scefrom/SF68/SF68.png

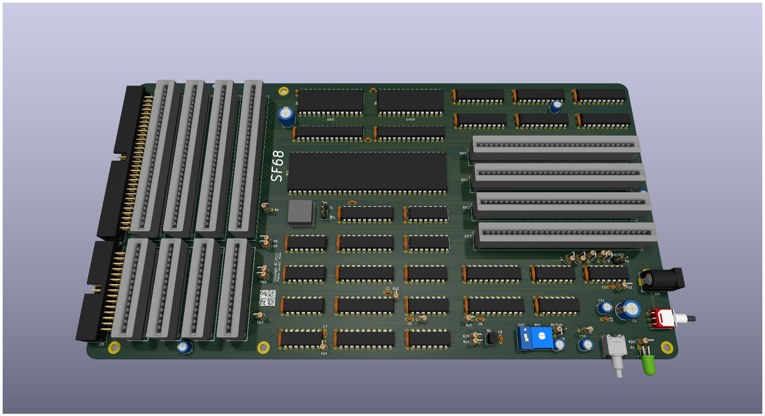
SF68.png
