scefrom/SF68/floppy/floppy_unrendered.png

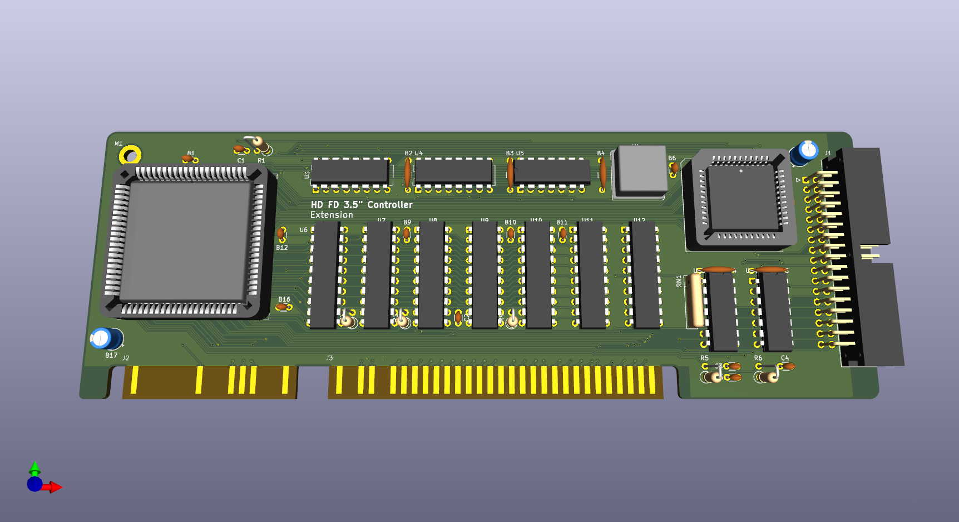
floppy/floppy_unrendered.png
