scefrom/SF68/floppy/floppy.png

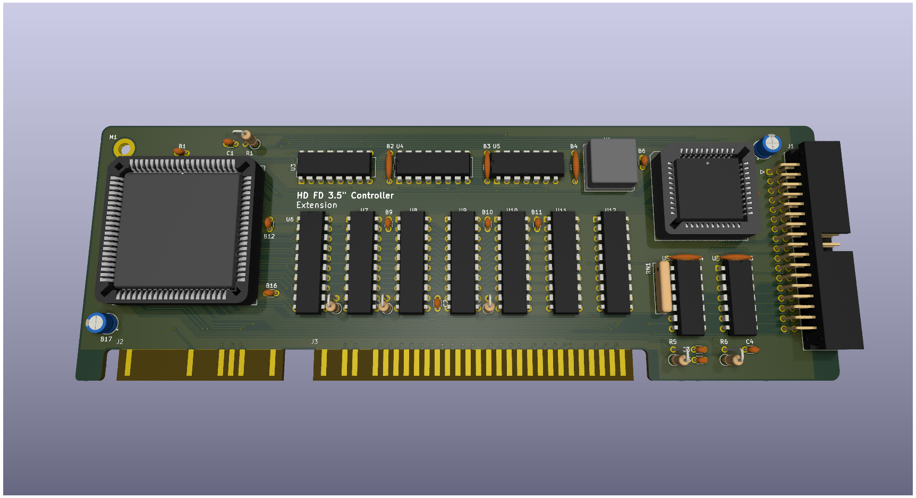
floppy/floppy.png
