scefrom/SF68/FOHWLdm.png

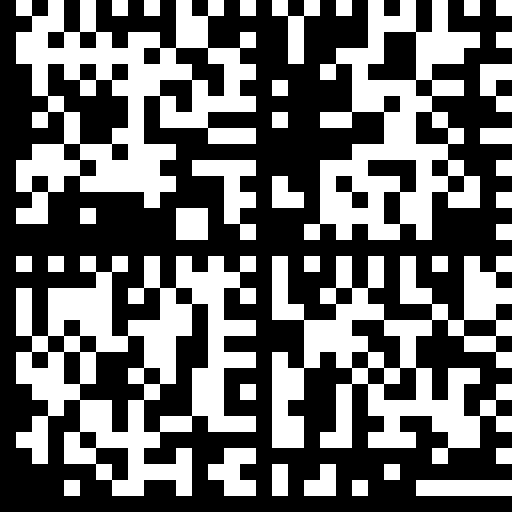
FOHWLdm.png
