scefrom/SF68/lcd2x16/lcd2x16.png

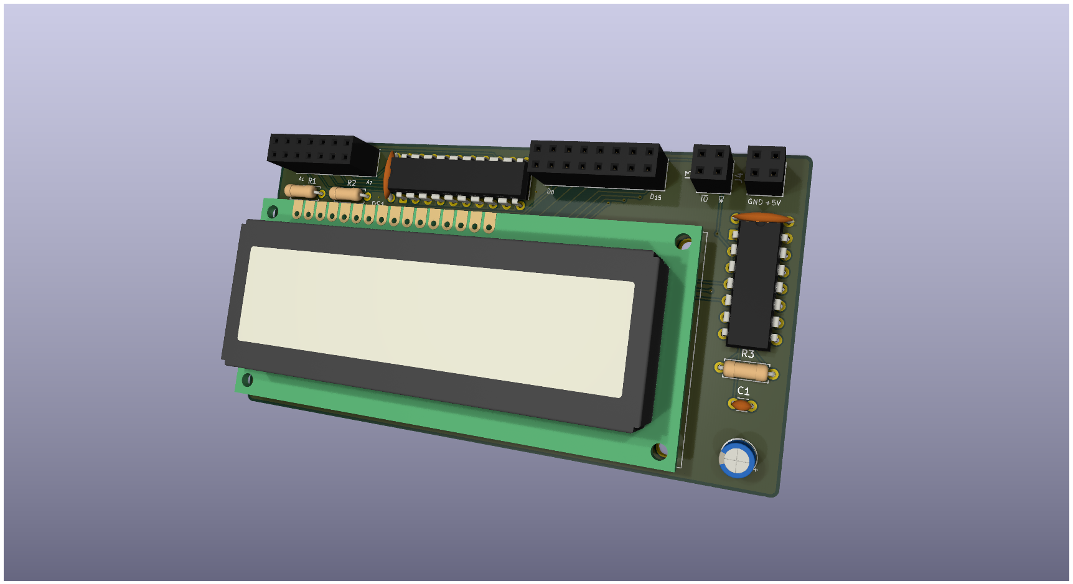
lcd2x16/lcd2x16.png
