scefrom/SF68/ps2/ps2.png

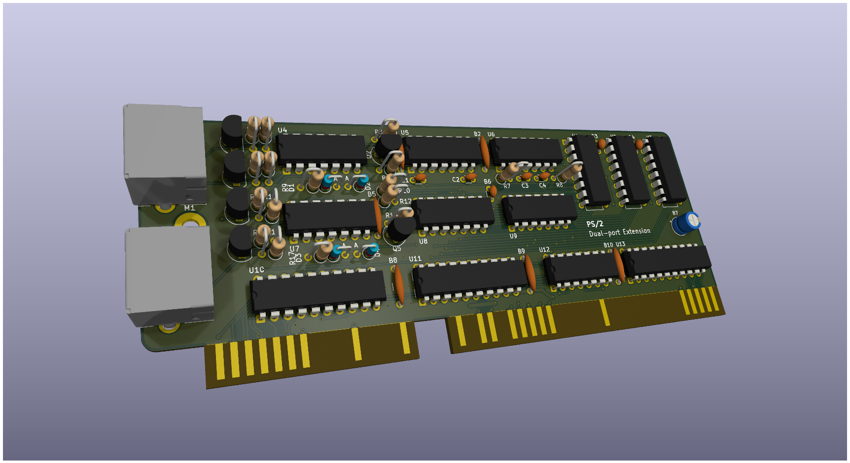
ps2/ps2.png
