scefrom/SF68/ps2/ps2_notht.png

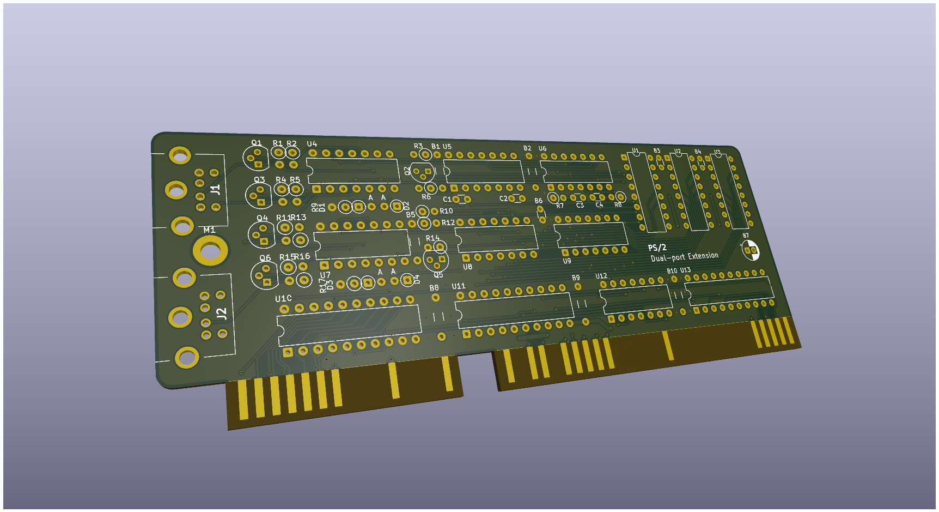
ps2/ps2_notht.png
