scefrom/SF68/ram1M/ram1M.png

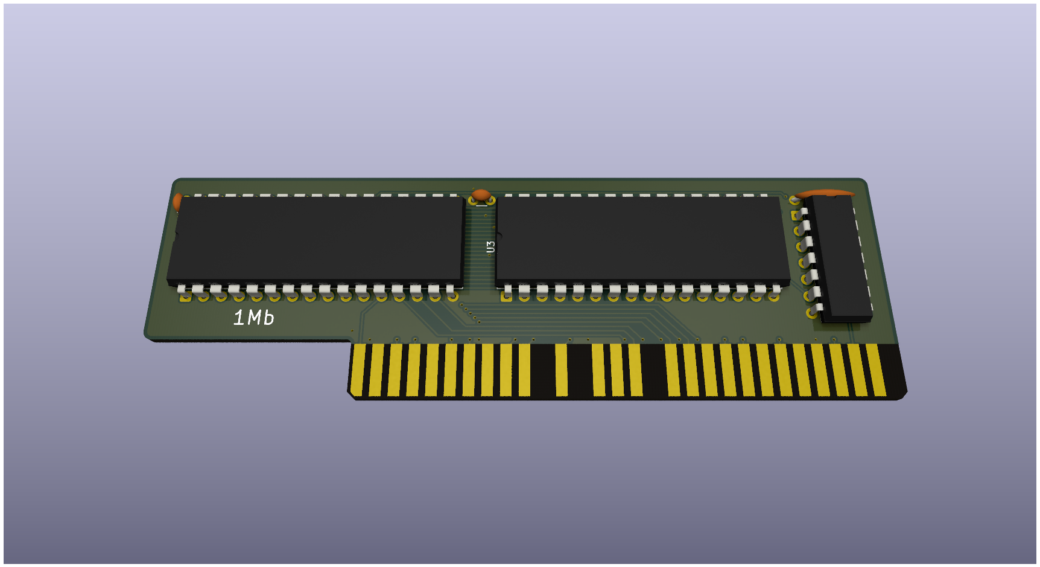
ram1M/ram1M.png
