scefrom/SF68/uart/uart/uart.png

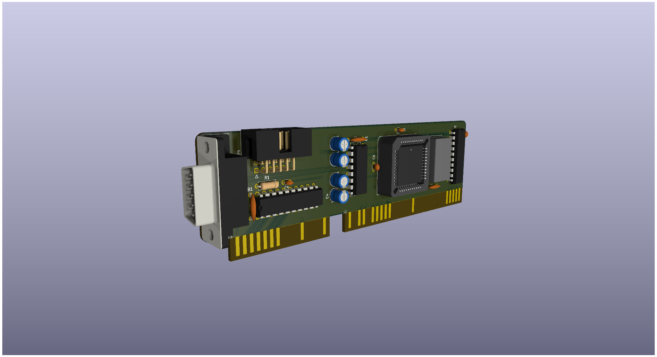
uart/uart/uart.png
