scefrom/SF68/vga/fctlines/vga_cpld_fctlines.png

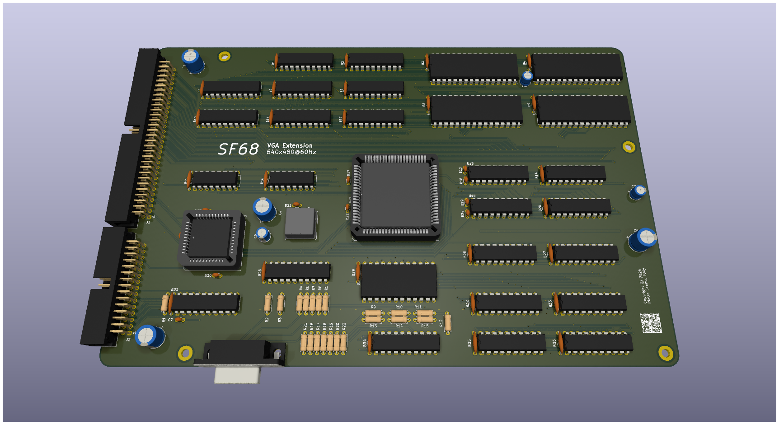
vga/fctlines/vga_cpld_fctlines.png
