scefrom/SF68/vga/jtag_fctlines/vga_cpld_jtag_fctlines.png

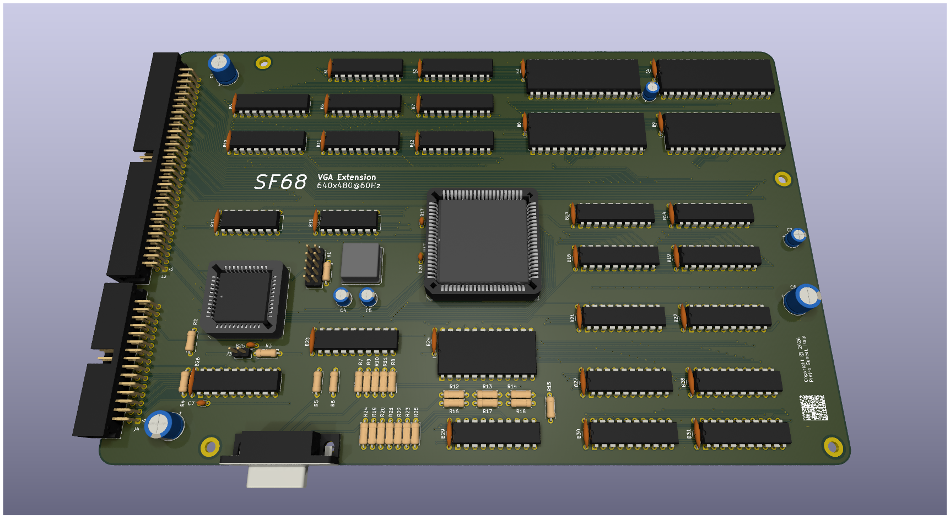
vga/jtag_fctlines/vga_cpld_jtag_fctlines.png
