scefrom/SF68/vga/vga_cpld.png

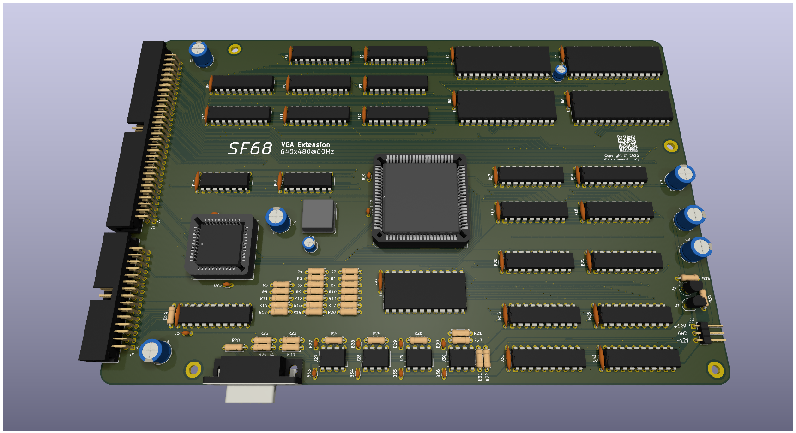
vga/vga_cpld.png
