scefrom/SF68/vga/vga_cpld_name.png

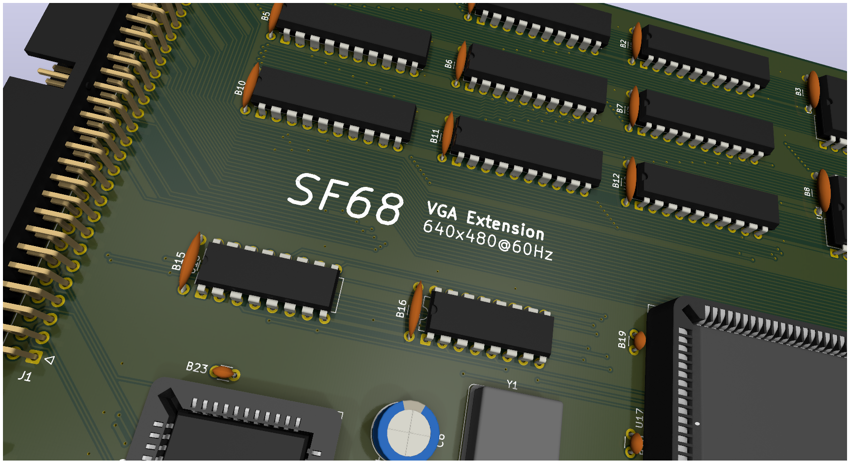
vga/vga_cpld_name.png
