scefrom/SF68/vga/vga_cpld_notht.png

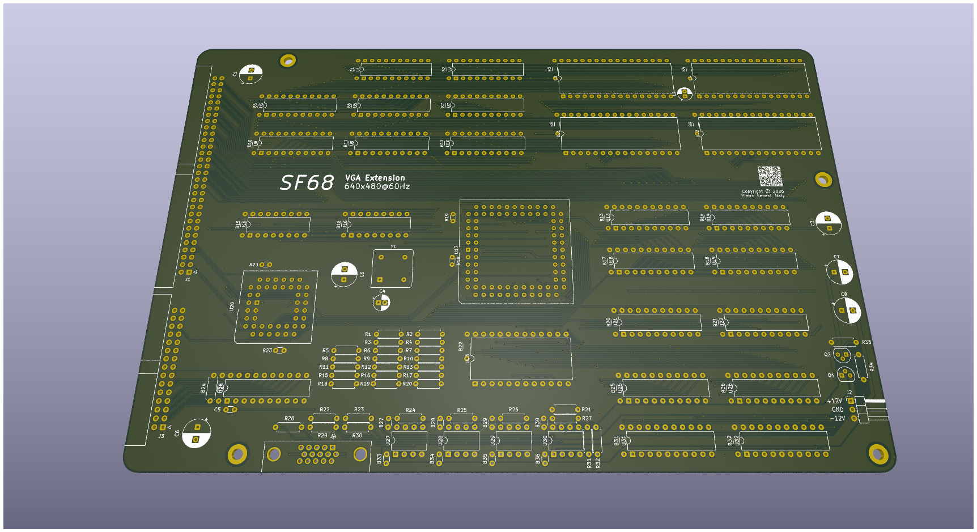
vga/vga_cpld_notht.png
