scefrom/SF68/vga/vga_palette_512x128.png

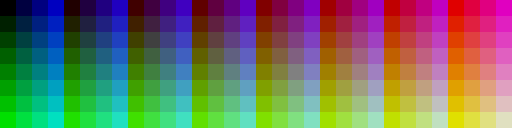
vga/vga_palette_512x128.png
