scefrom/SF68/vga/fctlines/vga_cpld_fctlines.pdf

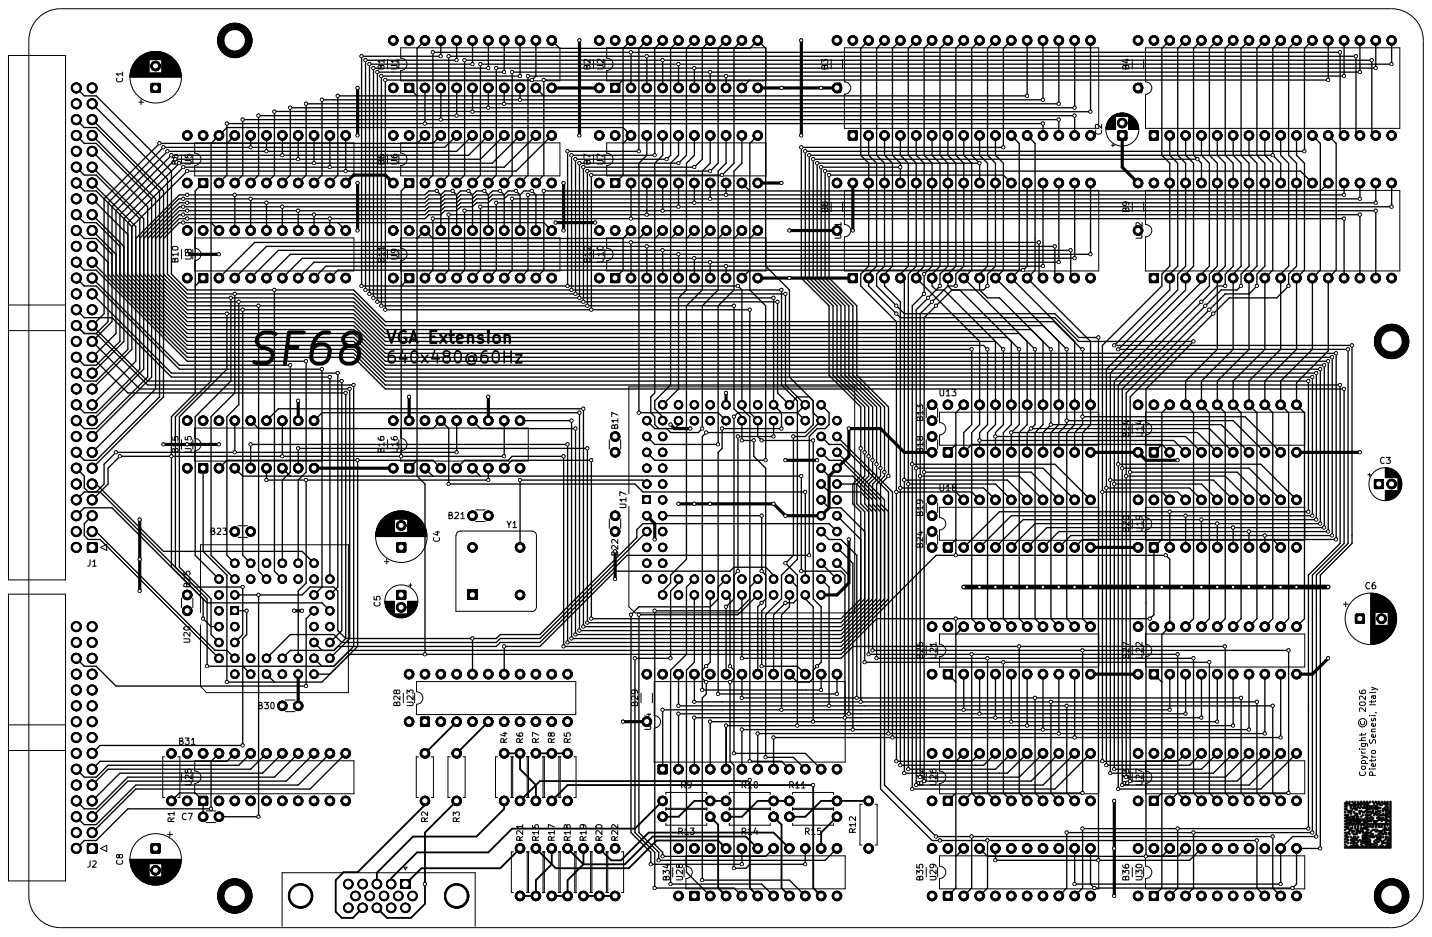
[picture p16: page 1]
