scefrom/SF68/vga/fctlines/vga_cpld_fctlines.kicad_pcb

## KiCad design vga/fctlines/vga_cpld_fctlines.kicad_pcb (2026-09-20)

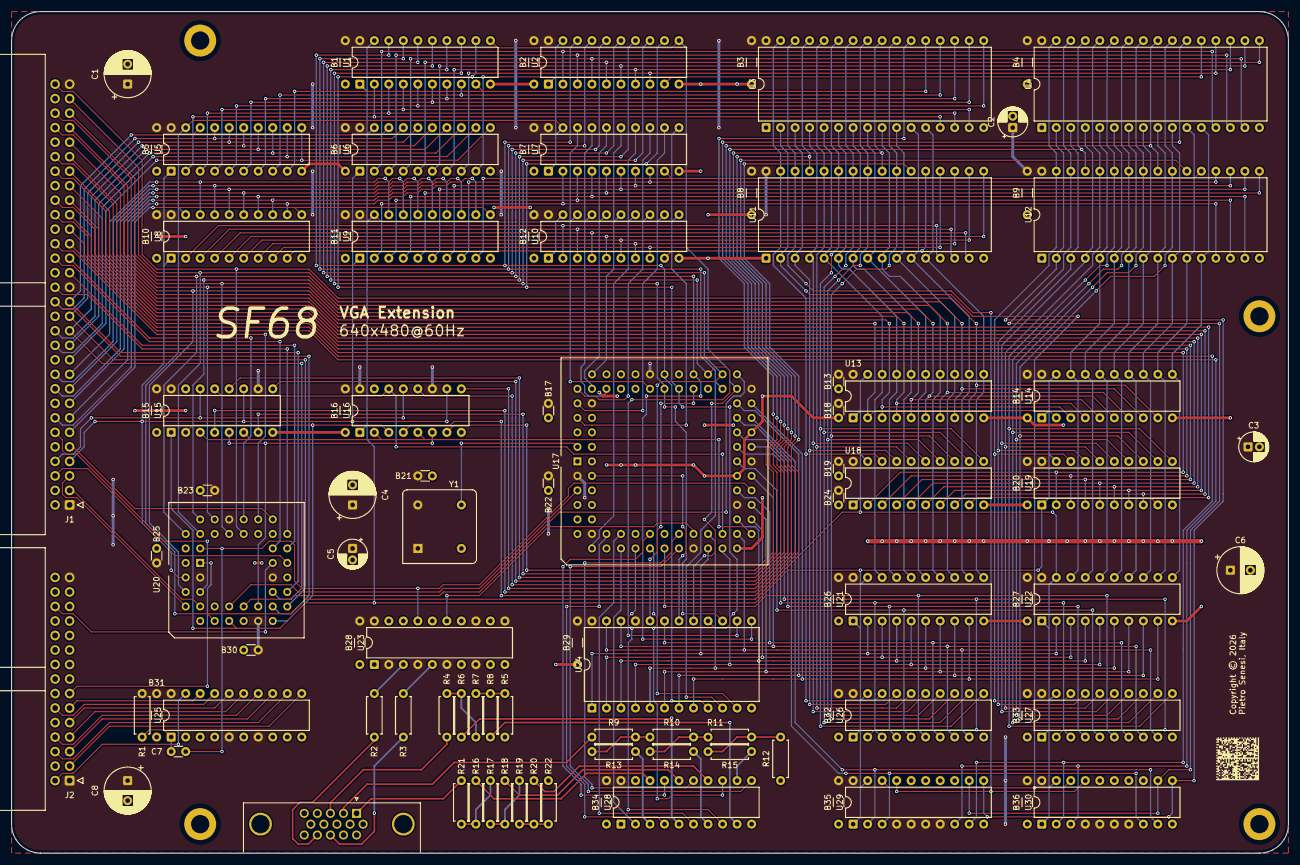
[picture p17: board vga_cpld_fctlines.kicad_pcb from above]

Board: 2 copper layers, 223.5 x 147.3 mm, 104 parts (0 on the bottom side), 214 nets.

Parts:
B1, B2, B3, B4, B5, B6, B7, B8, B9, B10, B11, B12, B14, B15, B16, B20, B26, B27, B28, B29, B31, B32, B33, B34, B35, B36: 100n; C_Disc_D3.0mm_W1.6mm_P7.62mm
B13, B17, B18, B19, B21, B22, B23, B24, B25, B30: 100n; C_Disc_D3.0mm_W1.6mm_P2.54mm
C1, C4, C6, C8: 100u; CP_Radial_D8.0mm_P3.50mm
C2, C3, C5: 10u; CP_Radial_D5.0mm_P2.00mm
C7: 22p; C_Disc_D3.0mm_W1.6mm_P2.54mm
J1: perslota; IDC-Header_2x30_P2.54mm_Horizontal
J2: perslotb; IDC-Header_2x15_P2.54mm_Horizontal
J3: vga_connector; DSUB-15-HD_Socket_Horizontal_P2.29x1.90mm_EdgePinOffset3.03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
M1, M2, M3, M4: MountingHole_3.2mm_M3_DIN965_Pad
R1: 4.7k; R_Axial_DIN0207_L6.3mm_D2.5mm_P7.62mm_Horizontal
R2, R3: 75; R_Axial_DIN0207_L6.3mm_D2.5mm_P7.62mm_Horizontal
R4: 226; R_Axial_DIN0207_L6.3mm_D2.5mm_P7.62mm_Horizontal
R5, R6, R8, R12, R13, R14, R15, R16, R18, R20, R22: 200; R_Axial_DIN0207_L6.3mm_D2.5mm_P7.62mm_Horizontal
R7, R10, R11, R17, R19: 100; R_Axial_DIN0207_L6.3mm_D2.5mm_P7.62mm_Horizontal
R9, R21: 294; R_Axial_DIN0207_L6.3mm_D2.5mm_P7.62mm_Horizontal
U1, U2, U7, U10, U13, U14, U18, U19, U21, U22, U26, U27, U29, U30: 74AHC541; DIP-20_W7.62mm
U3, U4, U11, U12: AS6C4008-55PCN; DIP-32_W15.24mm
U5, U6, U8, U9: 74HC245; DIP-20_W7.62mm
U15, U16: 74HC157; DIP-16_W7.62mm
U17: ATF1508AS-xJx84; PLCC-84_THT-Socket
U20: ATF1502AS-xJx44; PLCC-44_THT-Socket
U23, U28: CY74FCT244; DIP-20_W7.62mm
U24: AT28C16; DIP-24_W15.24mm
U25: 74HC541; DIP-20_W7.62mm
Y1: CXO_DIP8_25.175MHz; Oscillator_DIP-8

Connections:
+5V: B1.1, B2.1, B3.1, B4.1, B5.1, B6.1, B7.1, B8.1, B9.1, B10.1, B11.1, B12.1, B13.1, B14.1, B15.1, B16.1, B17.1, B18.1, B19.1, B20.1, B21.1, B22.1, B23.1, B24.1, B25.1, B26.1, B27.1, B28.1, B29.1, B30.1, B31.1, B32.1, B33.1, B34.1, B35.1, B36.1, C1.1, C2.1, C3.1, C4.1, C5.1, C6.1, C8.1, J1.1, J1.31, J1.59, J2.1, J2.29, R1.1, U1.20 (VCC), U2.20 (VCC), U3.32 (VCC), U4.32 (VCC), U5.20 (VCC), U6.20 (VCC), U7.20 (VCC), U8.20 (VCC), U9.20 (VCC), U10.20 (VCC), U11.32 (VCC), U12.32 (VCC), U13.20 (VCC), U14.20 (VCC), U15.10 (I1c), U15.16 (VCC), U16.11 (I0c), U16.16 (VCC), U17.3 (VCC_INT), U17.13 (VCC_IO), U17.26 (VCC_IO), U17.38 (VCC_IO), U17.43 (VCC_INT), U17.53 (VCC_IO), U17.66 (VCC_IO), U17.78 (VCC_IO), U18.20 (VCC), U19.20 (VCC), U20.3 (VCC), U20.15 (VCC), U20.23 (VCC), U20.35 (VCC), U21.20 (VCC), U22.20 (VCC), U23.2, U23.4, U23.6, U23.8, U23.11, U23.13, U23.20 (VCC), U24.21 (~WE), U24.24 (VCC), U25.5 (A3), U25.7 (A5), U25.20 (VCC), U26.20 (VCC), U27.20 (VCC), U28.20 (VCC), U29.4 (A2), U29.5 (A3), U29.6 (A4), U29.7 (A5), U29.20 (VCC), U30.4 (A2), U30.5 (A3), U30.6 (A4), U30.7 (A5), U30.20 (VCC), Y1.1 (EN), Y1.8 (Vcc)
/AC.~P: J2.26, U20.25 (I/O/PD2)
/ADR_{0}: U17.51 (I/O), U21.9 (A7), U22.9 (A7), U24.8 (A0)
/ADR_{1}: U17.52 (I/O), U21.8 (A6), U22.8 (A6), U24.7 (A1)
/ADR_{2}: U17.37 (I/O), U21.7 (A5), U22.7 (A5), U24.6 (A2)
/ADR_{3}: U17.29 (I/O), U21.6 (A4), U22.6 (A4), U24.5 (A3)
/ADR_{4}: U17.30 (I/O), U21.5 (A3), U22.5 (A3), U24.4 (A4)
/ADR_{5}: U17.36 (I/O), U21.4 (A2), U22.4 (A2), U24.3 (A5)
/ADR_{6}: U17.35 (I/O), U21.3 (A1), U22.3 (A1), U24.2 (A6)
/ADR_{7}: U17.28 (I/O), U21.2 (A0), U22.2 (A0), U24.1 (A7)
/ADR_{8}: U17.34 (I/O), U24.23 (A8), U26.9 (A7), U27.9 (A7)
/ADR_{9}: U17.41 (I/O), U24.22 (A9), U26.8 (A6), U27.8 (A6)
/ADR_{10}: U17.40 (I/O), U24.19 (A10), U26.7 (A5), U27.7 (A5)
/ADR_{11}: U17.22 (I/O), U26.6 (A4), U27.6 (A4)
/ADR_{12}: U17.44 (I/O), U26.5 (A3), U27.5 (A3)
/ADR_{13}: U17.48 (I/O), U26.4 (A2), U27.4 (A2)
/ADR_{14}: U17.46 (I/O), U26.3 (A1), U27.3 (A1)
/ADR_{15}: U17.45 (I/O/PD2), U26.2 (A0), U27.2 (A0)
/ADR_{16}: U17.49 (I/O), U29.2 (A0), U30.9 (A7)
/ADR_{17}: U17.50 (I/O), U29.3 (A1), U30.8 (A6)
/A_{1}: J1.60, U13.9 (A7), U14.9 (A7), U20.34 (I/O)
/A_{2}: J1.57, U13.8 (A6), U14.8 (A6), U20.41 (I/O/GCLK3)
/A_{3}: J1.55, U13.7 (A5), U14.7 (A5), U20.40 (I/O)
/A_{4}: J1.56, U13.6 (A4), U14.6 (A4), U20.39 (I/O)
/A_{5}: J1.53, U13.5 (A3), U14.5 (A3), U20.36 (I/O)
/A_{6}: J1.54, U13.4 (A2), U14.4 (A2), U20.37 (I/O)
/A_{7}: J1.51, U13.3 (A1), U14.3 (A1), U20.4 (I/O)
/A_{8}: J1.49, U13.2 (A0), U14.2 (A0)
/A_{9}: J1.50, U18.9 (A7), U19.9 (A7)
/A_{10}: J1.47, U18.8 (A6), U19.8 (A6)
/A_{11}: J1.48, U18.7 (A5), U19.7 (A5)
/A_{12}: J1.45, U18.6 (A4), U19.6 (A4)
/A_{13}: J1.43, U18.5 (A3), U19.5 (A3)
/A_{14}: J1.44, U18.4 (A2), U19.4 (A2)
/A_{15}: J1.41, U18.3 (A1), U19.3 (A1)
/A_{16}: J1.42, U18.2 (A0), U19.2 (A0)
/A_{17}: J1.39, U29.9 (A7), U30.2 (A0)
/A_{18}: J1.37, U29.8 (A6), U30.3 (A1)
/A_{19}: J1.38, U20.31 (I/O)
/A_{20}: J1.35, U20.33 (I/O)
/A_{21}: J1.36, U20.27 (I/O)
/A_{22}: J1.33, U20.26 (I/O)
/A_{23}: J1.32, U20.28 (I/O)
/BE.~IO: J1.12, U20.5 (I/O)
/BE.~M: J1.9, U20.29 (I/O)
/CLK: U17.83 (I/GCLK1), Y1.5 (OUT)
/CM: U17.5 (I/O), U20.12 (I/O)
/DAT_{0}: U1.18 (Y0), U2.18 (Y0), U17.64 (I/O), U24.9 (D0)
/DAT_{1}: U1.17 (Y1), U2.17 (Y1), U17.57 (I/O), U24.10 (D1)
/DAT_{2}: U1.16 (Y2), U2.16 (Y2), U17.56 (I/O), U24.11 (D2)
/DAT_{3}: U1.15 (Y3), U2.15 (Y3), U17.60 (I/O), U24.13 (D3)
/DAT_{4}: U1.14 (Y4), U2.14 (Y4), U17.58 (I/O), U24.14 (D4)
/DAT_{5}: U1.13 (Y5), U2.13 (Y5), U17.65 (I/O), U24.15 (D5)
/DAT_{6}: U1.12 (Y6), U2.12 (Y6), U17.63 (I/O), U24.16 (D6)
/DAT_{7}: U1.11 (Y7), U2.11 (Y7), U17.55 (I/O), U24.17 (D7)
/DAT_{8}: U7.18 (Y0), U10.18 (Y0), U17.67 (I/O)
/DAT_{9}: U7.17 (Y1), U10.17 (Y1), U17.73 (I/O)
/DAT_{10}: U7.16 (Y2), U10.16 (Y2), U17.76 (I/O)
/DAT_{11}: U7.15 (Y3), U10.15 (Y3), U17.74 (I/O)
/DAT_{12}: U7.14 (Y4), U10.14 (Y4), U17.12 (I/O/PD1)
/DAT_{13}: U7.13 (Y5), U10.13 (Y5), U17.75 (I/O)
/DAT_{14}: U7.12 (Y6), U10.12 (Y6), U17.77 (I/O)
/DAT_{15}: U7.11 (Y7), U10.11 (Y7), U17.79 (I/O)
/DIR.~R: J1.8, U15.14 (I0d), U16.13 (I1d)
/DIR.~W: J1.7, U5.1 (A->B), U6.1 (A->B), U8.1 (A->B), U9.1 (A->B), U15.11 (I0c), U16.10 (I1c), U20.2 (I/GCLK2/OE2)
/DS.~L: J1.6, U20.24 (I/O)
/DS.~U: J1.5, U20.6 (I/O)
/D_{0}: J1.29, U5.18 (B0), U6.18 (B0), U20.20 (I/O)
/D_{1}: J1.30, U5.17 (B1), U6.17 (B1), U20.19 (I/O)
/D_{2}: J1.27, U5.16 (B2), U6.16 (B2), U20.18 (I/O)
/D_{3}: J1.25, U5.15 (B3), U6.15 (B3), U20.21 (I/O)
/D_{4}: J1.26, U5.14 (B4), U6.14 (B4)
/D_{5}: J1.23, U5.13 (B5), U6.13 (B5)
/D_{6}: J1.24, U5.12 (B6), U6.12 (B6)
/D_{7}: J1.21, U5.11 (B7), U6.11 (B7)
/D_{8}: J1.19, U8.18 (B0), U9.18 (B0)
/D_{9}: J1.20, U8.17 (B1), U9.17 (B1)
/D_{10}: J1.17, U8.16 (B2), U9.16 (B2)
/D_{11}: J1.18, U8.15 (B3), U9.15 (B3)
/D_{12}: J1.15, U8.14 (B4), U9.14 (B4)
/D_{13}: J1.13, U8.13 (B5), U9.13 (B5)
/D_{14}: J1.14, U8.12 (B6), U9.12 (B6)
/D_{15}: J1.11, U8.11 (B7), U9.11 (B7)
/IBSY: J2.2, U25.19 (G2)
/IRQ_{0}: J2.11, U25.18 (Y0)
/IRQ_{1}: J2.12, U25.17 (Y1)
/IRQ_{2}: J2.9, U25.16 (Y2)
/IRQ_{3}: J2.7, U25.15 (Y3)
/IRQ_{4}: J2.8, U25.14 (Y4)
/IRQ_{5}: J2.5, U25.13 (Y5)
/IRQ_{6}: J2.6, U25.12 (Y6)
/IRQ_{7}: J2.3, U25.11 (Y7)
/RGB_{0}: U17.25 (I/O), U28.15
/RGB_{1}: U17.24 (I/O), U28.11
/RGB_{2}: U17.21 (I/O), U28.17
/RGB_{3}: U17.20 (I/O/PD), U28.13
/RGB_{4}: U17.18 (I/O), U28.8
/RGB_{5}: U17.16 (I/O), U28.2
/RGB_{6}: U17.15 (I/O), U28.4
/RGB_{7}: U17.17 (I/O), U28.6
/UP: U17.54 (I/O), U20.14 (I/O)
/VBS: U1.1 (G1), U1.19 (G2), U6.19 (CE), U9.19 (CE), U10.1 (G1), U10.19 (G2), U14.1 (G1), U14.19 (G2), U15.1 (S), U16.1 (S), U19.1 (G1), U19.19 (G2), U20.11 (I/O/PD1), U21.1 (G1), U21.19 (G2), U26.1 (G1), U26.19 (G2), U29.1 (G1), U29.19 (G2)
/VB_{0}A_{0}: U3.12 (A0), U11.12 (A0), U13.11 (Y7), U21.11 (Y7)
/VB_{0}A_{1}: U3.11 (A1), U11.11 (A1), U13.12 (Y6), U21.12 (Y6)
/VB_{0}A_{2}: U3.10 (A2), U11.10 (A2), U13.13 (Y5), U21.13 (Y5)
/VB_{0}A_{3}: U3.9 (A3), U11.9 (A3), U13.14 (Y4), U21.14 (Y4)
/VB_{0}A_{4}: U3.8 (A4), U11.8 (A4), U13.15 (Y3), U21.15 (Y3)
/VB_{0}A_{5}: U3.7 (A5), U11.7 (A5), U13.16 (Y2), U21.16 (Y2)
/VB_{0}A_{6}: U3.6 (A6), U11.6 (A6), U13.17 (Y1), U21.17 (Y1)
/VB_{0}A_{7}: U3.5 (A7), U11.5 (A7), U13.18 (Y0), U21.18 (Y0)
/VB_{0}A_{8}: U3.27 (A8), U11.27 (A8), U18.11 (Y7), U26.11 (Y7)
/VB_{0}A_{9}: U3.26 (A9), U11.26 (A9), U18.12 (Y6), U26.12 (Y6)
/VB_{0}A_{10}: U3.23 (A10), U11.23 (A10), U18.13 (Y5), U26.13 (Y5)
/VB_{0}A_{11}: U3.25 (A11), U11.25 (A11), U18.14 (Y4), U26.14 (Y4)
/VB_{0}A_{12}: U3.4 (A12), U11.4 (A12), U18.15 (Y3), U26.15 (Y3)
/VB_{0}A_{13}: U3.28 (A13), U11.28 (A13), U18.16 (Y2), U26.16 (Y2)
/VB_{0}A_{14}: U3.3 (A14), U11.3 (A14), U18.17 (Y1), U26.17 (Y1)
/VB_{0}A_{15}: U3.31 (A15), U11.31 (A15), U18.18 (Y0), U26.18 (Y0)
/VB_{0}A_{16}: U3.2 (A16), U11.2 (A16), U29.18 (Y0), U30.18 (Y0)
/VB_{0}A_{17}: U3.30 (A17), U11.30 (A17), U29.17 (Y1), U30.17 (Y1)
/VB_{0}C.~E_{L}: U3.22 (CE#), U16.7 (Zb)
/VB_{0}C.~E_{U}: U11.22 (CE#), U16.4 (Za)
/VB_{0}C.~R: U3.24 (OE#), U11.24 (OE#), U16.12 (Zd)
/VB_{0}C.~W: U3.29 (WE#), U11.29 (WE#), U16.9 (Zc)
/VB_{0}D_{0}: U1.2 (A0), U3.13 (DQ0), U5.2 (A0)
/VB_{0}D_{1}: U1.3 (A1), U3.14 (DQ1), U5.3 (A1)
/VB_{0}D_{2}: U1.4 (A2), U3.15 (DQ2), U5.4 (A2)
/VB_{0}D_{3}: U1.5 (A3), U3.17 (DQ3), U5.5 (A3)
/VB_{0}D_{4}: U1.6 (A4), U3.18 (DQ4), U5.6 (A4)
/VB_{0}D_{5}: U1.7 (A5), U3.19 (DQ5), U5.7 (A5)
/VB_{0}D_{6}: U1.8 (A6), U3.20 (DQ6), U5.8 (A6)
/VB_{0}D_{7}: U1.9 (A7), U3.21 (DQ7), U5.9 (A7)
/VB_{0}D_{8}: U8.2 (A0), U10.2 (A0), U11.13 (DQ0)
/VB_{0}D_{9}: U8.3 (A1), U10.3 (A1), U11.14 (DQ1)
/VB_{0}D_{10}: U8.4 (A2), U10.4 (A2), U11.15 (DQ2)
/VB_{0}D_{11}: U8.5 (A3), U10.5 (A3), U11.17 (DQ3)
/VB_{0}D_{12}: U8.6 (A4), U10.6 (A4), U11.18 (DQ4)
/VB_{0}D_{13}: U8.7 (A5), U10.7 (A5), U11.19 (DQ5)
/VB_{0}D_{14}: U8.8 (A6), U10.8 (A6), U11.20 (DQ6)
/VB_{0}D_{15}: U8.9 (A7), U10.9 (A7), U11.21 (DQ7)
/VB_{1}A_{0}: U4.12 (A0), U12.12 (A0), U14.11 (Y7), U22.11 (Y7)
/VB_{1}A_{1}: U4.11 (A1), U12.11 (A1), U14.12 (Y6), U22.12 (Y6)
/VB_{1}A_{2}: U4.10 (A2), U12.10 (A2), U14.13 (Y5), U22.13 (Y5)
/VB_{1}A_{3}: U4.9 (A3), U12.9 (A3), U14.14 (Y4), U22.14 (Y4)
/VB_{1}A_{4}: U4.8 (A4), U12.8 (A4), U14.15 (Y3), U22.15 (Y3)
/VB_{1}A_{5}: U4.7 (A5), U12.7 (A5), U14.16 (Y2), U22.16 (Y2)
/VB_{1}A_{6}: U4.6 (A6), U12.6 (A6), U14.17 (Y1), U22.17 (Y1)
/VB_{1}A_{7}: U4.5 (A7), U12.5 (A7), U14.18 (Y0), U22.18 (Y0)
/VB_{1}A_{8}: U4.27 (A8), U12.27 (A8), U19.11 (Y7), U27.11 (Y7)
/VB_{1}A_{9}: U4.26 (A9), U12.26 (A9), U19.12 (Y6), U27.12 (Y6)
/VB_{1}A_{10}: U4.23 (A10), U12.23 (A10), U19.13 (Y5), U27.13 (Y5)
/VB_{1}A_{11}: U4.25 (A11), U12.25 (A11), U19.14 (Y4), U27.14 (Y4)
/VB_{1}A_{12}: U4.4 (A12), U12.4 (A12), U19.15 (Y3), U27.15 (Y3)
/VB_{1}A_{13}: U4.28 (A13), U12.28 (A13), U19.16 (Y2), U27.16 (Y2)
/VB_{1}A_{14}: U4.3 (A14), U12.3 (A14), U19.17 (Y1), U27.17 (Y1)
/VB_{1}A_{15}: U4.31 (A15), U12.31 (A15), U19.18 (Y0), U27.18 (Y0)
/VB_{1}A_{16}: U4.2 (A16), U12.2 (A16), U29.11 (Y7), U30.11 (Y7)
/VB_{1}A_{17}: U4.30 (A17), U12.30 (A17), U29.12 (Y6), U30.12 (Y6)
/VB_{1}C.~E_{L}: U4.22 (CE#), U15.7 (Zb)
/VB_{1}C.~E_{U}: U12.22 (CE#), U15.4 (Za)
/VB_{1}C.~R: U4.24 (OE#), U12.24 (OE#), U15.12 (Zd)
/VB_{1}C.~W: U4.29 (WE#), U12.29 (WE#), U15.9 (Zc)
/VB_{1}D_{0}: U2.2 (A0), U4.13 (DQ0), U6.2 (A0)
/VB_{1}D_{1}: U2.3 (A1), U4.14 (DQ1), U6.3 (A1)
/VB_{1}D_{2}: U2.4 (A2), U4.15 (DQ2), U6.4 (A2)
/VB_{1}D_{3}: U2.5 (A3), U4.17 (DQ3), U6.5 (A3)
/VB_{1}D_{4}: U2.6 (A4), U4.18 (DQ4), U6.6 (A4)
/VB_{1}D_{5}: U2.7 (A5), U4.19 (DQ5), U6.7 (A5)
/VB_{1}D_{6}: U2.8 (A6), U4.20 (DQ6), U6.8 (A6)
/VB_{1}D_{7}: U2.9 (A7), U4.21 (DQ7), U6.9 (A7)
/VB_{1}D_{8}: U7.2 (A0), U9.2 (A0), U12.13 (DQ0)
/VB_{1}D_{9}: U7.3 (A1), U9.3 (A1), U12.14 (DQ1)
/VB_{1}D_{10}: U7.4 (A2), U9.4 (A2), U12.15 (DQ2)
/VB_{1}D_{11}: U7.5 (A3), U9.5 (A3), U12.17 (DQ3)
/VB_{1}D_{12}: U7.6 (A4), U9.6 (A4), U12.18 (DQ4)
/VB_{1}D_{13}: U7.7 (A5), U9.7 (A5), U12.19 (DQ5)
/VB_{1}D_{14}: U7.8 (A6), U9.8 (A6), U12.20 (DQ6)
/VB_{1}D_{15}: U7.9 (A7), U9.9 (A7), U12.21 (DQ7)
/vga_interface/BLUE: J3.3, R4.2
/vga_interface/GREEN: J3.2, R9.2
/vga_interface/RED: J3.1, R21.2
/vga_interface/~HSYNC: J3.13, R3.2
/vga_interface/~VSYNC: J3.14, R2.2
/~BE_{L}: U15.5 (I0b), U16.6 (I1b), U20.16 (I/O)
/~BE_{U}: U15.2 (I0a), U16.3 (I1a), U20.17 (I/O)
/~CME: U17.4 (I/O), U24.18 (~CE)
/~CMO: U17.61 (I/O), U24.20 (~OE)
/~HS: U17.27 (I/O), U23.15
/~RES: J2.13, U20.1 (I/GCLR)
/~RIH: J1.3, U20.8 (I/O)
/~VBS: U2.1 (G1), U2.19 (G2), U5.19 (CE), U7.1 (G1), U7.19 (G2), U8.19 (CE), U13.1 (G1), U13.19 (G2), U18.1 (G1), U18.19 (G2), U20.9 (I/O), U22.1 (G1), U22.19 (G2), U27.1 (G1), U27.19 (G2), U30.1 (G1), U30.19 (G2)
/~VME: U15.3 (I1a), U15.6 (I1b), U16.2 (I0a), U16.5 (I0b), U17.33 (I/O)
/~VMO: U15.13 (I1d), U16.14 (I0d), U17.31 (I/O)
/~VS: C7.2, U17.39 (I/O), U20.43 (I/GCLK1), U23.17
GND: B1.2, B2.2, B3.2, B4.2, B5.2, B6.2, B7.2, B8.2, B9.2, B10.2, B11.2, B12.2, B13.2, B14.2, B15.2, B16.2, B17.2, B18.2, B19.2, B20.2, B21.2, B22.2, B23.2, B24.2, B25.2, B26.2, B27.2, B28.2, B29.2, B30.2, B31.2, B32.2, B33.2, B34.2, B35.2, B36.2, C1.2, C2.2, C3.2, C4.2, C5.2, C6.2, C8.2, J1.4, J1.10, J1.16, J1.22, J1.28, J1.34, J1.40, J1.46, J1.52, J1.58, J2.4, J2.10, J2.16, J2.21, J2.22, J2.28, J3.0, J3.5, J3.6, J3.7, J3.8, J3.10, M1.1, M2.1, M3.1, M4.1, R5.2, R12.2, R22.2, U1.10 (GND), U2.10 (GND), U3.1 (A18), U3.16 (VSS), U4.1 (A18), U4.16 (VSS), U5.10 (GND), U6.10 (GND), U7.10 (GND), U8.10 (GND), U9.10 (GND), U10.10 (GND), U11.1 (A18), U11.16 (VSS), U12.1 (A18), U12.16 (VSS), U13.10 (GND), U14.10 (GND), U15.8 (GND), U15.15 (E), U16.8 (GND), U16.15 (E), U17.7 (GND), U17.19 (GND), U17.32 (GND), U17.42 (GND), U17.47 (GND), U17.59 (GND), U17.72 (GND), U17.82 (GND), U18.10 (GND), U19.10 (GND), U20.10 (GND), U20.22 (GND), U20.30 (GND), U20.42 (GND), U21.10 (GND), U22.10 (GND), U23.1, U23.10 (GND), U23.19, U24.12 (GND), U25.2 (A0), U25.3 (A1), U25.4 (A2), U25.6 (A4), U25.8 (A6), U25.9 (A7), U25.10 (GND), U26.10 (GND), U27.10 (GND), U28.1, U28.10 (GND), U28.19, U29.10 (GND), U30.10 (GND), Y1.4 (GND)
unnamed: R2.1, U23.3
unnamed: R3.1, U23.5
unnamed: R4.1, R6.2, R7.1
unnamed: R5.1, R7.2, R8.2
unnamed: R6.1, U28.5
unnamed: R8.1, U28.9
unnamed: R9.1, R10.1, R13.2
unnamed: R10.2, R11.1, R14.2
unnamed: R11.2, R12.1, R15.2
unnamed: R13.1, U28.3
unnamed: R14.1, U28.7
unnamed: R15.1, U28.12
unnamed: R16.1, U28.18
unnamed: R16.2, R17.1, R21.1
unnamed: R17.2, R18.2, R19.1
unnamed: R18.1, U28.16
unnamed: R19.2, R20.2, R22.1
unnamed: R20.1, U28.14
unnamed: C7.1, R1.2, U25.1 (G1)
