scefrom/SF68/spi/spi.kicad_pcb

## KiCad design spi/spi.kicad_pcb (2026-09-20)

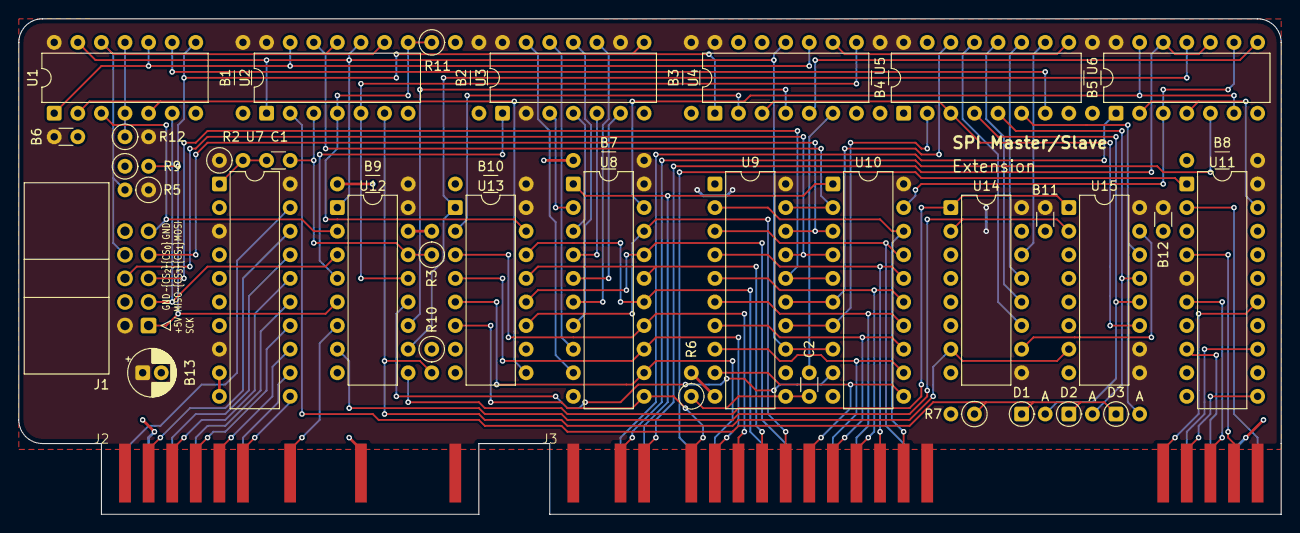
[picture p18: board spi.kicad_pcb from above]

Board: 2 copper layers, 135.9 x 53.3 mm, 45 parts (0 on the bottom side), 92 nets.

Parts:
B1, B2, B3, B4, B5, B7, B8, B9, B10: 100n; C_Disc_D3.0mm_W1.6mm_P7.62mm
B6, B11, B12: 100n; C_Disc_D3.0mm_W1.6mm_P2.54mm
B13: 10u; CP_Radial_D5.0mm_P2.00mm
C1, C2: 22pF; C_Disc_D3.0mm_W1.6mm_P2.54mm
D1, D2, D3: D_Schottky_Filled; D_DO-35_SOD27_P2.54mm_Vertical_AnodeUp
J1: spi-port; IDC-Header_2x05_P2.54mm_Horizontal
J2: perslot1b; edge_connector_15p_2.54mm
J3: perslot1a; edge_connector_30p_2.54mm
R2, R6: 1k; R_Axial_DIN0207_L6.3mm_D2.5mm_P2.54mm_Vertical
R3, R10, R11, R12: 10k; R_Axial_DIN0207_L6.3mm_D2.5mm_P2.54mm_Vertical
R5, R9: 4k7; R_Axial_DIN0207_L6.3mm_D2.5mm_P2.54mm_Vertical
R7: 2k; R_Axial_DIN0207_L6.3mm_D2.5mm_P2.54mm_Vertical
U1, U2: 74HC125; DIP-14_W7.62mm
U3: 74HC164; DIP-14_W7.62mm
U4: 74HC04; DIP-14_W7.62mm
U5: 74HC153; DIP-16_W7.62mm
U6: 74HC32; DIP-14_W7.62mm
U7, U8, U10: 74HC541; DIP-20_W7.62mm
U9: 74HC573; DIP-20_W7.62mm
U11: 74HC688; DIP-20_W7.62mm
U12: 74HC157; DIP-16_W7.62mm
U13: 74HC165; DIP-16_W7.62mm
U14, U15: 74HC161; DIP-16_W7.62mm

Connections:
+5V: B1.1, B2.1, B3.1, B4.1, B5.1, B6.1, B7.1, B8.1, B9.1, B10.1, B11.1, B12.1, B13.1, J1.2, J2.1, J2.29, J3.1, J3.31, J3.59, R2.1, R5.1, R12.2, U1.14 (VCC), U2.14 (VCC), U3.2 (DSB), U3.9 (~MR), U3.14 (VCC), U4.14 (VCC), U5.16 (VCC), U6.14 (VCC), U7.3 (A1), U7.8 (A6), U7.20 (VCC), U8.20 (VCC), U9.20 (VCC), U10.20 (VCC), U11.5 (R1), U11.20 (VCC), U12.16 (VCC), U13.16 (VCC), U14.9 (~PE), U14.16 (VCC), U15.9 (~PE), U15.10 (CET), U15.16 (VCC)
/A_{1}: J3.60, U11.2 (P0)
/A_{2}: J3.57, U11.4 (P1)
/A_{3}: J3.55, U11.6 (P2)
/A_{4}: J3.56, U11.8 (P3)
/A_{5}: J3.53, U11.11 (P4)
/A_{6}: J3.54, U11.13 (P5)
/A_{7}: J3.51, U11.15 (P6)
/CCK: U12.7 (Zb), U14.2 (CP), U15.2 (CP)
/CEN: R10.2, U2.6, U14.7 (CEP), U15.7 (CEP)
/CLK: J2.15, U12.6 (I1b)
/D_{0}: J3.29, U9.2 (D0), U10.18 (Y0)
/D_{1}: J3.30, U9.3 (D1), U10.17 (Y1)
/D_{2}: J3.27, U9.4 (D2), U10.16 (Y2)
/D_{3}: J3.25, U9.5 (D3), U10.15 (Y3)
/D_{4}: J3.26, U9.6 (D4), U10.14 (Y4)
/D_{5}: J3.23, U9.7 (D5), U10.13 (Y5)
/D_{6}: J3.24, U9.8 (D6), U10.12 (Y6)
/D_{7}: J3.21, U9.9 (D7), U10.11 (Y7)
/D_{8}: J3.19, U8.18 (Y0), U13.11 (D0)
/D_{9}: J3.20, U8.17 (Y1), U13.12 (D1)
/D_{10}: J3.17, U8.16 (Y2), U13.13 (D2)
/D_{11}: J3.18, U8.15 (Y3), U13.14 (D3)
/D_{12}: J3.15, U8.14 (Y4), U13.3 (D4)
/D_{13}: J3.13, U8.13 (Y5), U13.4 (D5)
/D_{14}: J3.14, U8.12 (Y6), U13.5 (D6)
/D_{15}: J3.11, U8.11 (Y7), U13.6 (D7)
/FQ_{0}: U5.14 (S0), U9.15 (Q4), U10.6 (A4)
/FQ_{1}: U5.2 (S1), U9.14 (Q5), U10.7 (A5)
/IBSY: J2.2, U7.19 (G2)
/IRQ_{0}: J2.11, U7.11 (Y7)
/IRQ_{1}: J2.12, U7.12 (Y6)
/IRQ_{2}: J2.9, U7.13 (Y5)
/IRQ_{3}: J2.7, U7.14 (Y4)
/IRQ_{4}: J2.8, U7.15 (Y3)
/IRQ_{5}: J2.5, U7.16 (Y2)
/IRQ_{6}: J2.6, U7.17 (Y1)
/IRQ_{7}: J2.3, U7.18 (Y0)
/MISO: J1.3, U1.6, U12.3 (I1a)
/MOSI: J1.9, U1.3, U12.2 (I0a)
/MST: U1.13, U2.1, U2.10, U4.11, U9.13 (Q6), U10.8 (A6), U12.1 (S)
/SCK: J1.1, R9.2, U1.8, U3.8 (CP), U4.1, U12.5 (I0b)
/SCK_{f0}: D3.2 (A), U5.6 (I0a), U15.14 (Q0)
/SCK_{f1}: D2.2 (A), U5.5 (I1a), U15.13 (Q1)
/SCK_{f2}: D1.2 (A), U5.4 (I2a), U15.12 (Q2)
/SCK_{f3}: U4.3, U5.3 (I3a), U15.11 (Q3)
/SIN: U3.1 (DSA), U12.4 (Za)
/SOUT: U1.2, U1.5, U13.9 (Q7)
/TRF: U10.9 (A7), U12.12 (Zd)
/TRF_{M}: U2.5, U4.8, U12.13 (I1d)
/TRF_{S}: C1.1, R3.1, U2.3, U12.14 (I0d)
/~CR: U12.9 (Zc), U14.1 (~MR), U15.1 (~MR)
/~CS_{0}: J1.8, R5.2, U1.12, U2.9, U2.11
/~CS_{1}: J1.7, U9.18 (Q1), U10.3 (A1)
/~CS_{2}: J1.6, U9.17 (Q2), U10.4 (A2)
/~CS_{3}: J1.5, U9.16 (Q3), U10.5 (A3)
/~DS: U6.6, U6.13, U8.19 (G2)
/~DW: U6.11, U12.10 (I1c), U13.1 (~PL)
/~FS: U6.3, U6.9, U10.19 (G2)
/~FW: U4.5, U6.8
/~IO: J3.12, U11.1 (G)
/~LS: J3.6, U6.1
/~MST: U1.1, U1.10, U2.13, U4.10
/~ON: R11.1, U2.4, U2.8, U13.15 (~CE)
/~RD: J3.8, U8.1 (G1), U10.1 (G1)
/~SCK: U4.2, U13.2 (CP)
/~S: U6.2, U6.4, U11.19 (P=R)
/~TRF_{f0}: U5.10 (I0b), U14.14 (Q0)
/~TRF_{f1}: U5.11 (I1b), U14.13 (Q1)
/~TRF_{f2}: U5.12 (I2b), U14.12 (Q2)
/~TRF_{f3}: U5.13 (I3b), U14.11 (Q3)
/~US: J3.5, U6.5
/~WR: J3.7, U6.10, U6.12
GND: B1.2, B2.2, B3.2, B4.2, B5.2, B6.2, B7.2, B8.2, B9.2, B10.2, B11.2, B12.2, B13.2, J1.4, J1.10, J2.4, J2.16, J2.21, J2.22, J2.28, J3.4, J3.22, J3.34, J3.40, J3.46, J3.52, J3.58, R3.2, R6.2, R7.2, R9.1, R10.1, R11.2, U1.7 (GND), U2.7 (GND), U3.7 (GND), U4.7 (GND), U4.13, U5.1 (Ea), U5.8 (GND), U5.15 (Eb), U6.7 (GND), U7.2 (A0), U7.4 (A2), U7.5 (A3), U7.6 (A4), U7.7 (A5), U7.9 (A7), U7.10 (GND), U8.10 (GND), U9.1 (OE), U9.10 (GND), U10.10 (GND), U11.3 (R0), U11.7 (R2), U11.9 (R3), U11.10 (GND), U11.12 (R4), U11.14 (R5), U11.16 (R6), U11.17 (P7), U11.18 (R7), U12.8 (GND), U12.15 (E), U13.8 (GND), U13.10 (DS), U14.3 (D0), U14.4 (D1), U14.5 (D2), U14.6 (D3), U14.8 (GND), U15.3 (D0), U15.4 (D1), U15.5 (D2), U15.6 (D3), U15.8 (GND)
unnamed: C2.1, U4.6
unnamed: D1.1 (K), D2.1 (K), D3.1 (K), R7.1, U2.2
unnamed: R12.1, U1.4, U1.11
unnamed: U3.3 (Q0), U8.2 (A0)
unnamed: U3.4 (Q1), U8.3 (A1)
unnamed: U3.5 (Q2), U8.4 (A2)
unnamed: U3.6 (Q3), U8.5 (A3)
unnamed: U3.10 (Q4), U8.6 (A4)
unnamed: U3.11 (Q5), U8.7 (A5)
unnamed: U3.12 (Q6), U8.8 (A6)
unnamed: U3.13 (Q7), U8.9 (A7)
unnamed: U1.9, U5.7 (Za)
unnamed: U4.9, U5.9 (Zb)
unnamed: C1.2, R2.2, U7.1 (G1)
unnamed: C2.2, R6.1, U9.11 (Load)
unnamed: U2.12, U9.19 (Q0), U10.2 (A0)
unnamed: U4.4, U12.11 (I0c)
unnamed: U14.10 (CET), U15.15 (TC)
