scefrom/SF68/uart/uart/uart.kicad_pcb

## KiCad design uart/uart/uart.kicad_pcb (2026-09-20)

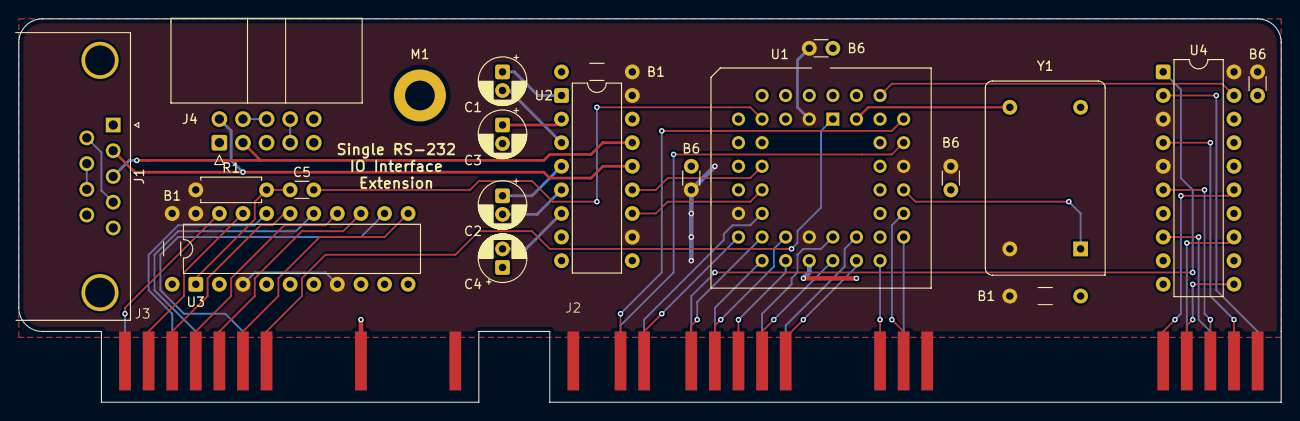
[picture p19: board uart.kicad_pcb from above]

Board: 2 copper layers, 135.9 x 41.3 mm, 23 parts (0 on the bottom side), 54 nets.

Parts:
B1, B1#2, B1#3: 100n; C_Disc_D3.0mm_W1.6mm_P7.62mm
B6, B6#2, B6#3, B6#4: 100n; C_Disc_D3.0mm_W1.6mm_P2.54mm
C1, C2, C3, C4: 1u; CP_Radial_D5.0mm_P2.00mm
C5: 22p; C_Disc_D3.0mm_W1.6mm_P2.54mm
J1: DE9_Pins_MountingHoles; DSUB-9_Pins_Horizontal_P2.77x2.84mm_EdgePinOffset7.70mm_Hou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
J2: perslota; edge_connector_30p_2.54mm
J3: perslotb; edge_connector_15p_2.54mm
J4: Conn_02x05_Top_Bottom; IDC-Header_2x05_P2.54mm_Horizontal
M1: MountingHole_3.2mm_M3_DIN965_Pad
R1: 4k7; R_Axial_DIN0207_L6.3mm_D2.5mm_P7.62mm_Horizontal
U1: ATF1504AS-xJx44; PLCC-44_THT-Socket
U2: MAX232; DIP-16_W7.62mm
U3: 74HC541; DIP-20_W7.62mm
U4: 74HC688; DIP-20_W7.62mm
Y1: 1.8432MHz; Oscillator_DIP-14

Connections:
+5V: B1.1, B1#2.1, B1#3.1, B6.1, B6#2.1, B6#3.1, B6#4.1, J2.1, J2.31, J2.59, J3.1, J3.29, R1.1, U1.3 (VCC), U1.15 (VCC), U1.23 (VCC), U1.35 (VCC), U2.10 (T2IN), U2.16 (VCC), U3.3 (A1), U3.7 (A5), U3.20 (VCC), U4.3 (R0), U4.5 (R1), U4.20 (VCC), Y1.14 (Vcc)
/A_{1}: J2.60, U4.2 (P0)
/A_{2}: J2.57, U4.4 (P1)
/A_{3}: J2.55, U4.6 (P2)
/A_{4}: J2.56, U4.8 (P3)
/A_{5}: J2.53, U4.11 (P4)
/A_{6}: J2.54, U4.13 (P5)
/A_{7}: J2.51, U4.15 (P6)
/CLK: U1.43 (I/GCLK1), Y1.8 (OUT)
/D_{0}: J2.29, U1.31 (I/O)
/D_{1}: J2.30, U1.29 (I/O)
/D_{2}: J2.27, U1.28 (I/O)
/D_{8}: J2.19, U1.26 (I/O)
/D_{9}: J2.20, U1.27 (I/O)
/D_{10}: J2.17, U1.24 (I/O)
/D_{11}: J2.18, U1.25 (I/O/PD2)
/D_{12}: J2.15, U1.20 (I/O)
/D_{13}: J2.13, U1.21 (I/O)
/D_{14}: J2.14, U1.18 (I/O)
/D_{15}: J2.11, U1.19 (I/O)
/IBSY: J3.2, U3.19 (G2)
/IRQ: C5.1, U1.8 (I/O)
/IRQ_{0}: J3.11, U3.11 (Y7)
/IRQ_{1}: J3.12, U3.12 (Y6)
/IRQ_{2}: J3.9, U3.13 (Y5)
/IRQ_{3}: J3.7, U3.14 (Y4)
/IRQ_{4}: J3.8, U3.15 (Y3)
/IRQ_{5}: J3.5, U3.16 (Y2)
/IRQ_{6}: J3.6, U3.17 (Y1)
/IRQ_{7}: J3.3, U3.18 (Y0)
/ON: U1.33 (I/O), Y1.1 (EN)
/RX: U1.12 (I/O), U2.12 (R1OUT)
/RX_{RS232}: J1.2, J4.2, U2.13 (R1IN)
/TX: U1.14 (I/O), U2.11 (T1IN)
/TX_{RS232}: J1.3, J4.3, U2.14 (T1OUT)
/~CS: U1.40 (I/O), U4.19 (P=R)
/~IOS: J2.12, U4.1 (G)
/~LS: J2.6, U1.37 (I/O)
/~RES: J3.13, U1.1 (I/GCLR)
/~RE: J2.8, U1.16 (I/O)
/~US: J2.5, U1.39 (I/O)
/~WE: J2.7, U1.17 (I/O)
GND: B1.2, B1#2.2, B1#3.2, B6.2, B6#2.2, B6#3.2, B6#4.2, C3.2, C4.1, J1.0 (PAD), J1.5, J2.4, J2.22, J2.28, J2.34, J2.40, J2.46, J2.52, J3.4, J3.16, J3.21, J3.22, J3.28, J4.5, M1.1, U1.10 (GND), U1.22 (GND), U1.30 (GND), U1.42 (GND), U2.15 (GND), U3.2 (A0), U3.4 (A2), U3.5 (A3), U3.6 (A4), U3.8 (A6), U3.9 (A7), U3.10 (GND), U4.7 (R2), U4.9 (R3), U4.10 (GND), U4.12 (R4), U4.14 (R5), U4.16 (R6), U4.17 (P7), U4.18 (R7), Y1.7 (GND)
unnamed: J1.4, J1.6
unnamed: J1.7, J1.8
unnamed: J4.4, J4.6
unnamed: J4.7, J4.8
unnamed: C1.1, U2.1 (C1+)
unnamed: C1.2, U2.3 (C1-)
unnamed: C2.1, U2.4 (C2+)
unnamed: C2.2, U2.5 (C2-)
unnamed: C3.1, U2.2 (VS+)
unnamed: C4.2, U2.6 (VS-)
unnamed: C5.2, R1.2, U3.1 (G1)
