scefrom/SF68/floppy/floppy.kicad_pcb

## KiCad design floppy/floppy.kicad_pcb (2026-09-20)

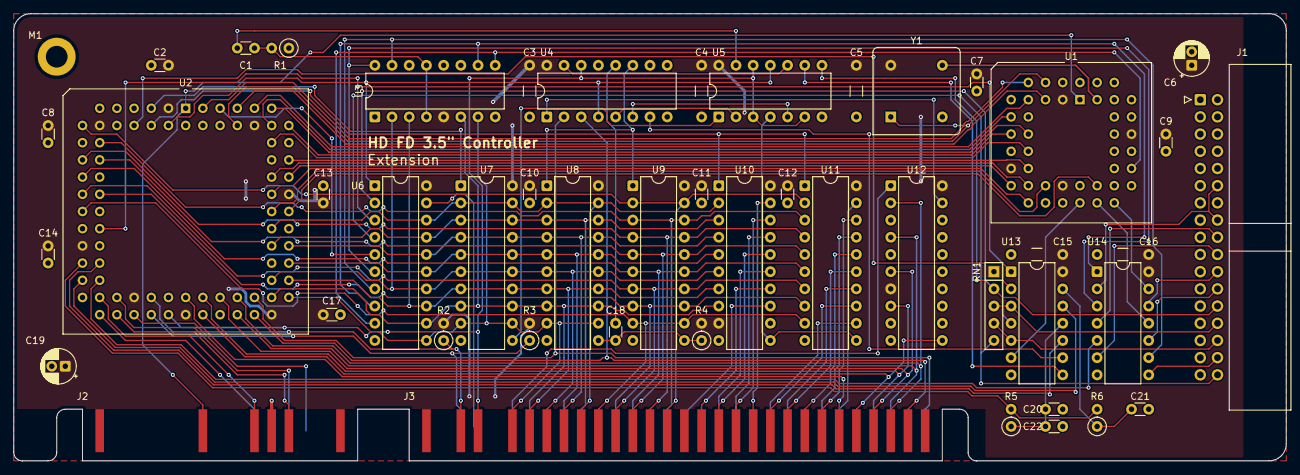
[picture p20: board floppy.kicad_pcb from above]

Board: 2 copper layers, 188.0 x 66.0 mm, 48 parts (0 on the bottom side), 110 nets.

Parts:
C1, C18: 22p; C_Disc_D3.0mm_W1.6mm_P2.54mm
C2, C7, C8, C9, C10, C11, C12, C13, C14, C17, C20, C22: 100n; C_Disc_D3.0mm_W1.6mm_P2.54mm
C3, C4, C5, C15, C16: 100n; C_Disc_D3.0mm_W1.6mm_P7.62mm
C6, C19: 10u; CP_Radial_D5.0mm_P2.00mm
C21: 220p; C_Disc_D3.0mm_W1.6mm_P2.54mm
J1: driveint; IDC-Header_2x17_P2.54mm_Horizontal
J2: perslotb; edge_connector_15p_2.54mm
J3: perslota; edge_connector_30p_2.54mm
M1: MountingHole_3.2mm_M3_DIN965_Pad
R1, R4: 4k7; R_Axial_DIN0207_L6.3mm_D2.5mm_P2.54mm_Vertical
R2, R3, R5, R6: 10k; R_Axial_DIN0207_L6.3mm_D2.5mm_P2.54mm_Vertical
RN1: 1k; R_Array_SIP5
U1: SF2202; PLCC-44_THT-Socket
U2: SF2203; PLCC-84_THT-Socket
U3: 74HC75; DIP-16_W7.62mm
U4: 74HC139; DIP-16_W7.62mm
U5: 74HC02; DIP-14_W7.62mm
U6: 74HC541; DIP-20_W7.62mm
U7, U8, U9, U10, U11: 74HC574; DIP-20_W7.62mm
U12: 74HC688; DIP-20_W7.62mm
U13: 74HC14; DIP-14_W7.62mm
U14: 74HC05; DIP-14_W7.62mm
Y1: 16MHz; Oscillator_DIP-8

Connections:
+5V: C2.1, C3.1, C4.1, C5.1, C6.1, C7.1, C8.1, C9.1, C10.1, C11.1, C12.1, C13.1, C14.1, C15.1, C16.1, C17.1, C19.1, J2.1, J2.29, J3.1, J3.31, J3.59, R2.2, R3.2, R4.2, RN1.1 (R1), U1.3 (VCC), U1.15 (VCC), U1.23 (VCC), U1.35 (VCC), U2.3 (VCC), U2.13 (VCC), U2.26 (VCC), U2.38 (VCC), U2.43 (VCC), U2.53 (VCC), U2.66 (VCC), U2.78 (VCC), U3.5 (VCC), U4.16 (VCC), U5.14 (VCC), U6.20 (VCC), U7.20 (VCC), U8.20 (VCC), U9.20 (VCC), U10.9 (D7), U10.20 (VCC), U11.20 (VCC), U12.7 (R2), U12.20 (VCC), U13.14 (VCC), U14.14 (VCC), Y1.8 (Vcc)
/A1M: U1.18 (A1M), U2.67 (A1M)
/A_{1}: J3.60, U2.52 (A_{0}), U4.2 (A0)
/A_{2}: J3.57, U2.51 (A_{1}), U4.3 (A1)
/A_{3}: J3.55, U2.50 (A_{2}), U12.2 (P0)
/A_{4}: J3.56, U2.49 (A_{3}), U12.4 (P1)
/A_{5}: J3.53, U2.48 (A_{4}), U12.6 (P2)
/A_{6}: J3.54, U2.46 (A_{5}), U12.8 (P3)
/A_{7}: J3.51, U2.45 (A_{6}), U12.11 (P4)
/A_{8}: J3.49, U2.44 (A_{7})
/A_{9}: J3.50, U11.19 (Q0)
/A_{10}: J3.47, U11.18 (Q1)
/A_{11}: J3.48, U11.17 (Q2)
/A_{12}: J3.45, U11.16 (Q3)
/A_{13}: J3.43, U11.15 (Q4)
/A_{14}: J3.44, U11.14 (Q5)
/A_{15}: J3.41, U11.13 (Q6)
/A_{16}: J3.42, U11.12 (Q7)
/A_{17}: J3.39, U10.19 (Q0)
/A_{18}: J3.37, U10.18 (Q1)
/A_{19}: J3.38, U10.17 (Q2)
/A_{20}: J3.35, U10.16 (Q3)
/A_{21}: J3.36, U10.15 (Q4)
/A_{22}: J3.33, U10.14 (Q5)
/A_{23}: J3.32, U10.13 (Q6)
/BRP: U1.21 (BRP), U2.65 (BRP)
/CDC: U1.5 (CDC), U2.79 (CDC)
/CDCD_{0}: U1.17 (D_{0}), U2.68 (CDCD_{0})
/CDCD_{1}: U1.19 (D_{1}), U2.69 (CDCD_{1})
/CDCD_{2}: U1.16 (D_{2}), U2.70 (CDCD_{2})
/CDCD_{3}: U1.14 (D_{3}), U2.73 (CDCD_{3})
/CDCD_{4}: U1.11 (D_{4}), U2.74 (CDCD_{4})
/CDCD_{5}: U1.12 (D_{5}), U2.75 (CDCD_{5})
/CDCD_{6}: U1.9 (D_{6}), U2.76 (CDCD_{6})
/CDCD_{7}: U1.8 (D_{7}), U2.77 (CDCD_{7})
/CDCE: U1.4 (EN), U2.80 (CDCE), Y1.1 (EN)
/CK16: U1.43 (CLK), Y1.5 (OUT)
/DCK: U1.6 (DCK), U2.83 (CLK)
/DIR: U3.16 (Q0), U6.6 (A4), U14.3
/DRS: U3.10 (Q2), U6.8 (A6), U14.1
/D_{0}: J3.29, U2.12 (D_{0}), U9.2 (D0), U9.19 (Q0), U11.2 (D0)
/D_{1}: J3.30, U2.15 (D_{1}), U9.3 (D1), U9.18 (Q1), U11.3 (D1)
/D_{2}: J3.27, U2.16 (D_{2}), U9.4 (D2), U9.17 (Q2), U11.4 (D2)
/D_{3}: J3.25, U2.17 (D_{3}), U9.5 (D3), U9.16 (Q3), U11.5 (D3)
/D_{4}: J3.26, U2.18 (D_{4}), U9.6 (D4), U9.15 (Q4), U11.6 (D4)
/D_{5}: J3.23, U2.20 (D_{5}), U9.7 (D5), U9.14 (Q5), U11.7 (D5)
/D_{6}: J3.24, U2.21 (D_{6}), U9.8 (D6), U9.13 (Q6), U11.8 (D6)
/D_{7}: J3.21, U2.22 (D_{7}), U9.9 (D7), U9.12 (Q7), U11.9 (D7)
/D_{8}: J3.19, U2.63 (D_{8}), U6.18 (Y0), U7.2 (D0), U7.19 (Q0), U8.2 (D0), U8.19 (Q0), U10.2 (D0)
/D_{9}: J3.20, U2.61 (D_{9}), U6.17 (Y1), U7.3 (D1), U7.18 (Q1), U8.3 (D1), U8.18 (Q1), U10.3 (D1)
/D_{10}: J3.17, U2.60 (D_{10}), U6.16 (Y2), U7.4 (D2), U7.17 (Q2), U8.4 (D2), U8.17 (Q2), U10.4 (D2)
/D_{11}: J3.18, U2.58 (D_{11}), U6.15 (Y3), U7.5 (D3), U7.16 (Q3), U8.5 (D3), U8.16 (Q3), U10.5 (D3)
/D_{12}: J3.15, U2.57 (D_{12}), U3.2 (D0), U6.14 (Y4), U7.6 (D4), U7.15 (Q4), U8.6 (D4), U8.15 (Q4), U10.6 (D4)
/D_{13}: J3.13, U2.56 (D_{13}), U3.3 (D1), U6.13 (Y5), U7.7 (D5), U7.14 (Q5), U8.7 (D5), U8.14 (Q5), U10.7 (D5)
/D_{14}: J3.14, U2.55 (D_{14}), U3.6 (D2), U6.12 (Y6), U7.8 (D6), U7.13 (Q6), U8.8 (D6), U8.13 (Q6), U10.8 (D6)
/D_{15}: J3.11, U2.54 (D_{15}), U3.7 (D3), U6.11 (Y7), U7.9 (D7), U7.12 (Q7), U8.9 (D7), U8.12 (Q7)
/RD: U1.24 (RD), U13.6
/SIDE: U3.15 (Q1), U6.7 (A5), U14.9
/STEP: U2.31 (STP), U14.5
/WG: U1.26 (WG), U14.11
/WP: U2.25 (WP), U6.3 (A1), U13.4
/WPC: U1.31 (WPC), U3.9 (Q3), U6.9 (A7)
/WR: U1.28 (WR), U14.13
/WRP: U1.27 (WRP), U2.64 (WRP)
/~ASH: U4.5 (O1), U5.2
/~AS: U2.5 (AS), U7.1 (OE)
/~BG: J2.20, U2.33 (BG)
/~BR: J2.19, U2.34 (BR)
/~BUSY: U2.81 (BSY), U6.5 (A3)
/~CRCSH: U4.7 (O3), U13.9
/~CRCS: U2.8 (CRCS), U13.1
/~CS: U2.4 (CS), U4.4 (O0), U5.11, U6.1 (G1)
/~DA: J2.24, U2.36 (DA)
/~DCHG: J1.34, RN1.5 (R4.2), U6.4 (A2)
/~DIR: J1.18, U14.4
/~DRS/~MON: J1.12, J1.16, U14.2
/~DS: U2.6 (DS), U10.1 (OE), U11.1 (OE)
/~EA: J2.26, U2.37 (EA)
/~IOS: J3.12, U12.1 (G)
/~LS: J3.6, R3.1, U2.39 (LS)
/~MAS: U4.6 (O2), U5.5
/~RD: J1.30, RN1.4 (R3.2), U13.5
/~RES: J2.13, U1.1 (MR), U2.1 (MR)
/~RE: J3.8, U6.19 (G2)
/~SIDE: J1.32, U14.8
/~STEP: J1.20, U14.6
/~TR0: J1.26, RN1.2 (R1.2), U6.2 (A0)
/~UA: J2.23, U2.35 (UA)
/~US: J3.5, R2.1, U2.40 (US)
/~WE: J3.7, U2.41 (WE), U4.14 (A0), U5.3, U5.6, U5.12
/~WG: J1.24, U14.10
/~WP: J1.28, RN1.3 (R2.2), U13.3
/~WR: J1.22, U14.12
GND: C2.2, C3.2, C4.2, C5.2, C6.2, C7.2, C8.2, C9.2, C10.2, C11.2, C12.2, C13.2, C14.2, C15.2, C16.2, C17.2, C19.2, C20.2, C21.2, C22.2, J1.7, J1.9, J1.11, J1.13, J1.15, J1.17, J1.19, J1.21, J1.23, J1.25, J1.27, J1.29, J1.31, J1.33, J2.4, J2.10, J2.16, J2.21, J2.22, J2.28, J3.4, J3.10, J3.22, J3.40, J3.52, M1.1, R1.1, U1.10 (GND), U1.22 (GND), U1.30 (GND), U1.42 (GND), U2.7 (GND), U2.19 (GND), U2.32 (GND), U2.42 (GND), U2.47 (GND), U2.59 (GND), U2.72 (GND), U2.82 (GND), U3.12 (GND), U4.8 (GND), U4.13 (A1), U5.7 (GND), U6.10 (GND), U7.10 (GND), U8.10 (GND), U9.10 (GND), U10.10 (GND), U11.10 (GND), U12.3 (R0), U12.5 (R1), U12.9 (R3), U12.10 (GND), U12.12 (R4), U12.13 (P5), U12.14 (R5), U12.15 (P6), U12.16 (R6), U12.17 (P7), U12.18 (R7), U13.7 (GND), U14.7 (GND), Y1.4 (GND)
unnamed: C1.1, U5.13
unnamed: C20.1, C22.1, R5.1, U13.11
unnamed: C21.1, R6.1, U13.13
unnamed: U2.29 (STPBK), U13.10
unnamed: R5.2, R6.2, U2.28 (STPJ)
unnamed: U2.30 (STPK), U13.12
unnamed: C1.2, R1.2, U3.4 (E23), U3.13 (E01)
unnamed: U4.15 (E), U5.10
unnamed: C18.1, U4.12 (O0)
unnamed: U4.11 (O1), U8.1 (OE), U9.1 (OE)
unnamed: U5.1, U7.11 (Cp)
unnamed: C18.2, R4.1, U8.11 (Cp), U9.11 (Cp)
unnamed: U5.4, U10.11 (Cp), U11.11 (Cp)
unnamed: U4.1 (E), U12.19 (P=R)
unnamed: U5.8, U13.2
unnamed: U5.9, U13.8
