scefrom/SF68/vga/jtag/vga_cpld_jtag.kicad_pcb

## KiCad design vga/jtag/vga_cpld_jtag.kicad_pcb (2026-03-09)

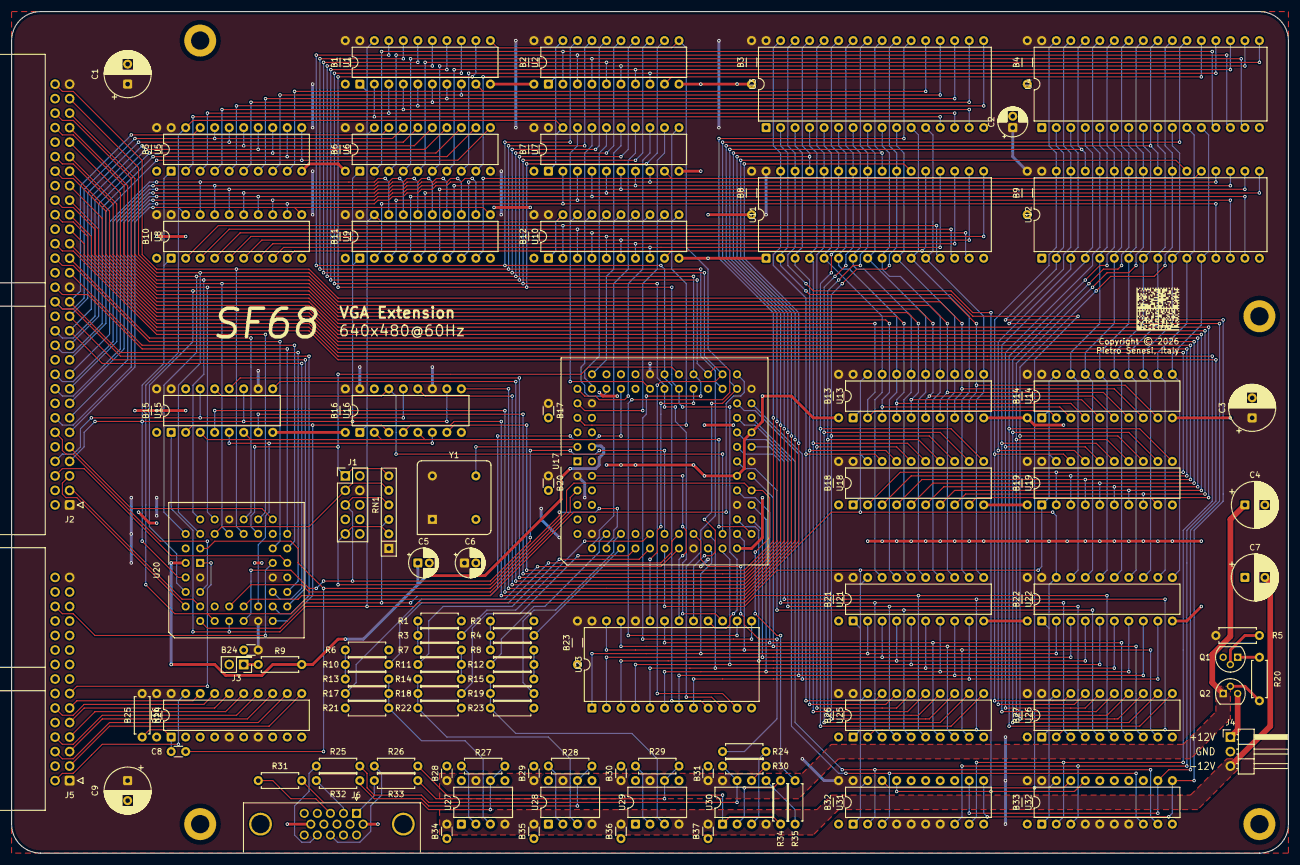
[picture p21: board vga_cpld_jtag.kicad_pcb from above]

Board: 2 copper layers, 223.5 x 147.3 mm, 127 parts (0 on the bottom side), 229 nets.

Parts:
B1, B2, B3, B4, B5, B6, B7, B8, B9, B10, B11, B12, B13, B14, B15, B16, B18, B19, B21, B22, B23, B25, B26, B27, B32, B33: 100n; C_Disc_D3.0mm_W1.6mm_P7.62mm
B17, B20, B24, B28, B29, B30, B31, B34, B35, B36, B37: 100n; C_Disc_D3.0mm_W1.6mm_P2.54mm
C1, C3, C4, C7, C9: 100u; CP_Radial_D8.0mm_P3.50mm
C2, C5, C6: 10u; CP_Radial_D5.0mm_P2.00mm
C8: 22p; C_Disc_D3.0mm_W1.6mm_P2.54mm
J1: jtag; PinHeader_2x05_P2.54mm_Vertical
J2: perslota; IDC-Header_2x30_P2.54mm_Horizontal
J3: oe1_12v_bypass; PinHeader_2x01_P2.54mm_Vertical
J4: vgasupply; PinHeader_1x03_P2.54mm_Horizontal
J5: perslotb; IDC-Header_2x15_P2.54mm_Horizontal
J6: DE15_Socket_HighDensity; DSUB-15-HD_Socket_Horizontal_P2.29x1.90mm_EdgePinOffset3.03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
M1, M2, M3, M4: MountingHole_3.2mm_M3_DIN965_Pad
Q1: Q_NPN_CBE; TO-92
Q2: Q_PNP_CBE; TO-92
R1, R2, R3, R4, R6, R10, R11, R12, R17, R18, R19, R20: 5.4k; R_Axial_DIN0207_L6.3mm_D2.5mm_P7.62mm_Horizontal
R5: 10k; R_Axial_DIN0207_L6.3mm_D2.5mm_P7.62mm_Horizontal
R7, R8, R13, R14, R15: 2.7k; R_Axial_DIN0207_L6.3mm_D2.5mm_P7.62mm_Horizontal
R9, R24, R30, R34, R35: 1k; R_Axial_DIN0207_L6.3mm_D2.5mm_P7.62mm_Horizontal
R16: 4.7k; R_Axial_DIN0207_L6.3mm_D2.5mm_P7.62mm_Horizontal
R21, R22, R23: 800; R_Axial_DIN0207_L6.3mm_D2.5mm_P7.62mm_Horizontal
R25, R26: 50; R_Axial_DIN0207_L6.3mm_D2.5mm_P7.62mm_Horizontal
R27, R28, R29: 620; R_Axial_DIN0207_L6.3mm_D2.5mm_P7.62mm_Horizontal
R31, R32, R33: 33; R_Axial_DIN0207_L6.3mm_D2.5mm_P7.62mm_Horizontal
RN1: 10k; R_Array_SIP6
U1, U2, U7, U10, U13, U14, U18, U19, U21, U22, U25, U26, U31, U32: 74AHC541; DIP-20_W7.62mm
U3, U4, U11, U12: AS6C4008-55PCN; DIP-32_W15.24mm
U5, U6, U8, U9: 74HC245; DIP-20_W7.62mm
U15, U16: 74HC157; DIP-16_W7.62mm
U17: ATF1508AS-xJx84; PLCC-84_THT-Socket
U20: ATF1502AS-xJx44; PLCC-44_THT-Socket
U23: AT28C16; DIP-24_W15.24mm
U24: 74HC541; DIP-20_W7.62mm
U27, U28, U29: LM6171xxN; DIP-8_W7.62mm
U30: LM6172; DIP-8_W7.62mm
Y1: CXO_DIP8_25.175MHz; Oscillator_DIP-8

Connections:
+5V: B1.1, B2.1, B3.1, B4.1, B5.1, B6.1, B7.1, B8.1, B9.1, B10.1, B11.1, B12.1, B13.1, B14.1, B15.1, B16.1, B17.1, B18.1, B19.1, B20.1, B21.1, B22.1, B23.1, B24.1, B25.1, B26.1, B27.1, B32.1, B33.1, C1.1, C2.1, C3.1, C6.1, C9.1, J1.4, J2.1, J2.31, J2.59, J5.1, J5.29, R5.1, R16.1, RN1.1 (common), U1.20 (VCC), U2.20 (VCC), U3.32 (VCC), U4.32 (VCC), U5.20 (VCC), U6.20 (VCC), U7.20 (VCC), U8.20 (VCC), U9.20 (VCC), U10.20 (VCC), U11.32 (VCC), U12.32 (VCC), U13.20 (VCC), U14.20 (VCC), U15.10 (I1c), U15.16 (VCC), U16.11 (I0c), U16.16 (VCC), U17.3 (VCC_INT), U17.13 (VCC_IO), U17.26 (VCC_IO), U17.38 (VCC_IO), U17.43 (VCC_INT), U17.53 (VCC_IO), U17.66 (VCC_IO), U17.78 (VCC_IO), U18.20 (VCC), U19.20 (VCC), U20.3 (VCC), U20.15 (VCC), U20.23 (VCC), U20.35 (VCC), U21.20 (VCC), U22.20 (VCC), U23.21 (~WE), U23.24 (VCC), U24.5 (A3), U24.7 (A5), U24.20 (VCC), U25.20 (VCC), U26.20 (VCC), U31.4 (A2), U31.5 (A3), U31.6 (A4), U31.7 (A5), U31.20 (VCC), U32.4 (A2), U32.5 (A3), U32.6 (A4), U32.7 (A5), U32.20 (VCC), Y1.1 (EN), Y1.8 (Vcc)
/08to02: RN1.3 (R2), U17.71 (I/O/TDO), U20.7 (I/O/TDI)
/AC.~P: J5.26, U20.25 (I/O/PD2)
/ADR_{0}: U17.51 (I/O), U21.9 (A7), U22.9 (A7), U23.8 (A0)
/ADR_{1}: U17.52 (I/O), U21.8 (A6), U22.8 (A6), U23.7 (A1)
/ADR_{2}: U17.37 (I/O), U21.7 (A5), U22.7 (A5), U23.6 (A2)
/ADR_{3}: U17.29 (I/O), U21.6 (A4), U22.6 (A4), U23.5 (A3)
/ADR_{4}: U17.30 (I/O), U21.5 (A3), U22.5 (A3), U23.4 (A4)
/ADR_{5}: U17.36 (I/O), U21.4 (A2), U22.4 (A2), U23.3 (A5)
/ADR_{6}: U17.35 (I/O), U21.3 (A1), U22.3 (A1), U23.2 (A6)
/ADR_{7}: U17.28 (I/O), U21.2 (A0), U22.2 (A0), U23.1 (A7)
/ADR_{8}: U17.34 (I/O), U23.23 (A8), U25.9 (A7), U26.9 (A7)
/ADR_{9}: U17.41 (I/O), U23.22 (A9), U25.8 (A6), U26.8 (A6)
/ADR_{10}: U17.40 (I/O), U23.19 (A10), U25.7 (A5), U26.7 (A5)
/ADR_{11}: U17.22 (I/O), U25.6 (A4), U26.6 (A4)
/ADR_{12}: U17.44 (I/O), U25.5 (A3), U26.5 (A3)
/ADR_{13}: U17.48 (I/O), U25.4 (A2), U26.4 (A2)
/ADR_{14}: U17.46 (I/O), U25.3 (A1), U26.3 (A1)
/ADR_{15}: U17.45 (I/O/PD2), U25.2 (A0), U26.2 (A0)
/ADR_{16}: U17.49 (I/O), U31.2 (A0), U32.9 (A7)
/ADR_{17}: U17.50 (I/O), U31.3 (A1), U32.8 (A6)
/A_{1}: J2.60, U13.9 (A7), U14.9 (A7), U20.34 (I/O)
/A_{2}: J2.57, U13.8 (A6), U14.8 (A6), U20.41 (I/O/GCLK3)
/A_{3}: J2.55, U13.7 (A5), U14.7 (A5), U20.40 (I/O)
/A_{4}: J2.56, U13.6 (A4), U14.6 (A4), U20.39 (I/O)
/A_{5}: J2.53, U13.5 (A3), U14.5 (A3), U20.36 (I/O)
/A_{6}: J2.54, U13.4 (A2), U14.4 (A2), U20.37 (I/O)
/A_{7}: J2.51, U13.3 (A1), U14.3 (A1), U20.4 (I/O)
/A_{8}: J2.49, U13.2 (A0), U14.2 (A0)
/A_{9}: J2.50, U18.9 (A7), U19.9 (A7)
/A_{10}: J2.47, U18.8 (A6), U19.8 (A6)
/A_{11}: J2.48, U18.7 (A5), U19.7 (A5)
/A_{12}: J2.45, U18.6 (A4), U19.6 (A4)
/A_{13}: J2.43, U18.5 (A3), U19.5 (A3)
/A_{14}: J2.44, U18.4 (A2), U19.4 (A2)
/A_{15}: J2.41, U18.3 (A1), U19.3 (A1)
/A_{16}: J2.42, U18.2 (A0), U19.2 (A0)
/A_{17}: J2.39, U31.9 (A7), U32.2 (A0)
/A_{18}: J2.37, U31.8 (A6), U32.3 (A1)
/A_{19}: J2.38, U20.31 (I/O)
/A_{20}: J2.35, U20.33 (I/O)
/A_{21}: J2.36, U20.27 (I/O)
/A_{22}: J2.33, U20.26 (I/O)
/A_{23}: J2.32, U20.28 (I/O)
/BE.~IO: J2.12, U20.5 (I/O)
/BE.~M: J2.9, U20.29 (I/O)
/CLK: U17.83 (I/GCLK1), Y1.5 (OUT)
/CM: U17.5 (I/O), U20.12 (I/O)
/DAT_{0}: U1.18 (Y0), U2.18 (Y0), U17.64 (I/O), U23.9 (D0)
/DAT_{1}: U1.17 (Y1), U2.17 (Y1), U17.57 (I/O), U23.10 (D1)
/DAT_{2}: U1.16 (Y2), U2.16 (Y2), U17.56 (I/O), U23.11 (D2)
/DAT_{3}: U1.15 (Y3), U2.15 (Y3), U17.60 (I/O), U23.13 (D3)
/DAT_{4}: U1.14 (Y4), U2.14 (Y4), U17.58 (I/O), U23.14 (D4)
/DAT_{5}: U1.13 (Y5), U2.13 (Y5), U17.65 (I/O), U23.15 (D5)
/DAT_{6}: U1.12 (Y6), U2.12 (Y6), U17.63 (I/O), U23.16 (D6)
/DAT_{7}: U1.11 (Y7), U2.11 (Y7), U17.55 (I/O), U23.17 (D7)
/DAT_{8}: U7.18 (Y0), U10.18 (Y0), U17.67 (I/O)
/DAT_{9}: U7.17 (Y1), U10.17 (Y1), U17.73 (I/O)
/DAT_{10}: U7.16 (Y2), U10.16 (Y2), U17.76 (I/O)
/DAT_{11}: U7.15 (Y3), U10.15 (Y3), U17.74 (I/O)
/DAT_{12}: U7.14 (Y4), U10.14 (Y4), U17.12 (I/O/PD1)
/DAT_{13}: U7.13 (Y5), U10.13 (Y5), U17.75 (I/O)
/DAT_{14}: U7.12 (Y6), U10.12 (Y6), U17.77 (I/O)
/DAT_{15}: U7.11 (Y7), U10.11 (Y7), U17.79 (I/O)
/DIR.~R: J2.8, U15.14 (I0d), U16.13 (I1d)
/DIR.~W: J2.7, U5.1 (A->B), U6.1 (A->B), U8.1 (A->B), U9.1 (A->B), U15.11 (I0c), U16.10 (I1c), U20.2 (I/GCLK2/OE2)
/DS.~L: J2.6, U20.24 (I/O)
/DS.~U: J2.5, U20.6 (I/O)
/D_{0}: J2.29, U5.18 (B0), U6.18 (B0), U20.20 (I/O)
/D_{1}: J2.30, U5.17 (B1), U6.17 (B1), U20.19 (I/O)
/D_{2}: J2.27, U5.16 (B2), U6.16 (B2), U20.18 (I/O)
/D_{3}: J2.25, U5.15 (B3), U6.15 (B3), U20.21 (I/O)
/D_{4}: J2.26, U5.14 (B4), U6.14 (B4)
/D_{5}: J2.23, U5.13 (B5), U6.13 (B5)
/D_{6}: J2.24, U5.12 (B6), U6.12 (B6)
/D_{7}: J2.21, U5.11 (B7), U6.11 (B7)
/D_{8}: J2.19, U8.18 (B0), U9.18 (B0)
/D_{9}: J2.20, U8.17 (B1), U9.17 (B1)
/D_{10}: J2.17, U8.16 (B2), U9.16 (B2)
/D_{11}: J2.18, U8.15 (B3), U9.15 (B3)
/D_{12}: J2.15, U8.14 (B4), U9.14 (B4)
/D_{13}: J2.13, U8.13 (B5), U9.13 (B5)
/D_{14}: J2.14, U8.12 (B6), U9.12 (B6)
/D_{15}: J2.11, U8.11 (B7), U9.11 (B7)
/IBSY: J5.2, U24.19 (G2)
/IRQ_{0}: J5.11, U24.18 (Y0)
/IRQ_{1}: J5.12, U24.17 (Y1)
/IRQ_{2}: J5.9, U24.16 (Y2)
/IRQ_{3}: J5.7, U24.15 (Y3)
/IRQ_{4}: J5.8, U24.14 (Y4)
/IRQ_{5}: J5.5, U24.13 (Y5)
/IRQ_{6}: J5.6, U24.12 (Y6)
/IRQ_{7}: J5.3, U24.11 (Y7)
/JTAG.TCK: J1.1, RN1.6 (R5), U17.62 (I/O/TCK), U20.32 (I/O/TCK)
/JTAG.TDI: J1.9, RN1.2 (R1), U17.14 (I/O/TDI)
/JTAG.TDO: J1.3, RN1.5 (R4), U20.38 (I/O/TDO)
/JTAG.TMS: J1.5, RN1.4 (R3), U17.23 (I/O/TMS), U20.13 (I/O/TMS)
/RGB_{0}: R10.1, U17.25 (I/O)
/RGB_{1}: R17.1, U17.24 (I/O)
/RGB_{2}: R3.1, U17.21 (I/O)
/RGB_{3}: R11.1, U17.20 (I/O/PD)
/RGB_{4}: R18.1, U17.18 (I/O)
/RGB_{5}: R4.1, U17.16 (I/O)
/RGB_{6}: R12.1, U17.15 (I/O)
/RGB_{7}: R19.1, U17.17 (I/O)
/UP: U17.54 (I/O), U20.14 (I/O)
/VBS: U1.1 (G1), U1.19 (G2), U6.19 (CE), U9.19 (CE), U10.1 (G1), U10.19 (G2), U14.1 (G1), U14.19 (G2), U15.1 (S), U16.1 (S), U19.1 (G1), U19.19 (G2), U20.11 (I/O/PD1), U21.1 (G1), U21.19 (G2), U25.1 (G1), U25.19 (G2), U31.1 (G1), U31.19 (G2)
/VB_{0}A_{0}: U3.12 (A0), U11.12 (A0), U13.11 (Y7), U21.11 (Y7)
/VB_{0}A_{1}: U3.11 (A1), U11.11 (A1), U13.12 (Y6), U21.12 (Y6)
/VB_{0}A_{2}: U3.10 (A2), U11.10 (A2), U13.13 (Y5), U21.13 (Y5)
/VB_{0}A_{3}: U3.9 (A3), U11.9 (A3), U13.14 (Y4), U21.14 (Y4)
/VB_{0}A_{4}: U3.8 (A4), U11.8 (A4), U13.15 (Y3), U21.15 (Y3)
/VB_{0}A_{5}: U3.7 (A5), U11.7 (A5), U13.16 (Y2), U21.16 (Y2)
/VB_{0}A_{6}: U3.6 (A6), U11.6 (A6), U13.17 (Y1), U21.17 (Y1)
/VB_{0}A_{7}: U3.5 (A7), U11.5 (A7), U13.18 (Y0), U21.18 (Y0)
/VB_{0}A_{8}: U3.27 (A8), U11.27 (A8), U18.11 (Y7), U25.11 (Y7)
/VB_{0}A_{9}: U3.26 (A9), U11.26 (A9), U18.12 (Y6), U25.12 (Y6)
/VB_{0}A_{10}: U3.23 (A10), U11.23 (A10), U18.13 (Y5), U25.13 (Y5)
/VB_{0}A_{11}: U3.25 (A11), U11.25 (A11), U18.14 (Y4), U25.14 (Y4)
/VB_{0}A_{12}: U3.4 (A12), U11.4 (A12), U18.15 (Y3), U25.15 (Y3)
/VB_{0}A_{13}: U3.28 (A13), U11.28 (A13), U18.16 (Y2), U25.16 (Y2)
/VB_{0}A_{14}: U3.3 (A14), U11.3 (A14), U18.17 (Y1), U25.17 (Y1)
/VB_{0}A_{15}: U3.31 (A15), U11.31 (A15), U18.18 (Y0), U25.18 (Y0)
/VB_{0}A_{16}: U3.2 (A16), U11.2 (A16), U31.18 (Y0), U32.18 (Y0)
/VB_{0}A_{17}: U3.30 (A17), U11.30 (A17), U31.17 (Y1), U32.17 (Y1)
/VB_{0}C.~E_{L}: U3.22 (CE#), U16.7 (Zb)
/VB_{0}C.~E_{U}: U11.22 (CE#), U16.4 (Za)
/VB_{0}C.~R: U3.24 (OE#), U11.24 (OE#), U16.12 (Zd)
/VB_{0}C.~W: U3.29 (WE#), U11.29 (WE#), U16.9 (Zc)
/VB_{0}D_{0}: U1.2 (A0), U3.13 (DQ0), U5.2 (A0)
/VB_{0}D_{1}: U1.3 (A1), U3.14 (DQ1), U5.3 (A1)
/VB_{0}D_{2}: U1.4 (A2), U3.15 (DQ2), U5.4 (A2)
/VB_{0}D_{3}: U1.5 (A3), U3.17 (DQ3), U5.5 (A3)
/VB_{0}D_{4}: U1.6 (A4), U3.18 (DQ4), U5.6 (A4)
/VB_{0}D_{5}: U1.7 (A5), U3.19 (DQ5), U5.7 (A5)
/VB_{0}D_{6}: U1.8 (A6), U3.20 (DQ6), U5.8 (A6)
/VB_{0}D_{7}: U1.9 (A7), U3.21 (DQ7), U5.9 (A7)
/VB_{0}D_{8}: U8.2 (A0), U10.2 (A0), U11.13 (DQ0)
/VB_{0}D_{9}: U8.3 (A1), U10.3 (A1), U11.14 (DQ1)
/VB_{0}D_{10}: U8.4 (A2), U10.4 (A2), U11.15 (DQ2)
/VB_{0}D_{11}: U8.5 (A3), U10.5 (A3), U11.17 (DQ3)
/VB_{0}D_{12}: U8.6 (A4), U10.6 (A4), U11.18 (DQ4)
/VB_{0}D_{13}: U8.7 (A5), U10.7 (A5), U11.19 (DQ5)
/VB_{0}D_{14}: U8.8 (A6), U10.8 (A6), U11.20 (DQ6)
/VB_{0}D_{15}: U8.9 (A7), U10.9 (A7), U11.21 (DQ7)
/VB_{1}A_{0}: U4.12 (A0), U12.12 (A0), U14.11 (Y7), U22.11 (Y7)
/VB_{1}A_{1}: U4.11 (A1), U12.11 (A1), U14.12 (Y6), U22.12 (Y6)
/VB_{1}A_{2}: U4.10 (A2), U12.10 (A2), U14.13 (Y5), U22.13 (Y5)
/VB_{1}A_{3}: U4.9 (A3), U12.9 (A3), U14.14 (Y4), U22.14 (Y4)
/VB_{1}A_{4}: U4.8 (A4), U12.8 (A4), U14.15 (Y3), U22.15 (Y3)
/VB_{1}A_{5}: U4.7 (A5), U12.7 (A5), U14.16 (Y2), U22.16 (Y2)
/VB_{1}A_{6}: U4.6 (A6), U12.6 (A6), U14.17 (Y1), U22.17 (Y1)
/VB_{1}A_{7}: U4.5 (A7), U12.5 (A7), U14.18 (Y0), U22.18 (Y0)
/VB_{1}A_{8}: U4.27 (A8), U12.27 (A8), U19.11 (Y7), U26.11 (Y7)
/VB_{1}A_{9}: U4.26 (A9), U12.26 (A9), U19.12 (Y6), U26.12 (Y6)
/VB_{1}A_{10}: U4.23 (A10), U12.23 (A10), U19.13 (Y5), U26.13 (Y5)
/VB_{1}A_{11}: U4.25 (A11), U12.25 (A11), U19.14 (Y4), U26.14 (Y4)
/VB_{1}A_{12}: U4.4 (A12), U12.4 (A12), U19.15 (Y3), U26.15 (Y3)
/VB_{1}A_{13}: U4.28 (A13), U12.28 (A13), U19.16 (Y2), U26.16 (Y2)
/VB_{1}A_{14}: U4.3 (A14), U12.3 (A14), U19.17 (Y1), U26.17 (Y1)
/VB_{1}A_{15}: U4.31 (A15), U12.31 (A15), U19.18 (Y0), U26.18 (Y0)
/VB_{1}A_{16}: U4.2 (A16), U12.2 (A16), U31.11 (Y7), U32.11 (Y7)
/VB_{1}A_{17}: U4.30 (A17), U12.30 (A17), U31.12 (Y6), U32.12 (Y6)
/VB_{1}C.~E_{L}: U4.22 (CE#), U15.7 (Zb)
/VB_{1}C.~E_{U}: U12.22 (CE#), U15.4 (Za)
/VB_{1}C.~R: U4.24 (OE#), U12.24 (OE#), U15.12 (Zd)
/VB_{1}C.~W: U4.29 (WE#), U12.29 (WE#), U15.9 (Zc)
/VB_{1}D_{0}: U2.2 (A0), U4.13 (DQ0), U6.2 (A0)
/VB_{1}D_{1}: U2.3 (A1), U4.14 (DQ1), U6.3 (A1)
/VB_{1}D_{2}: U2.4 (A2), U4.15 (DQ2), U6.4 (A2)
/VB_{1}D_{3}: U2.5 (A3), U4.17 (DQ3), U6.5 (A3)
/VB_{1}D_{4}: U2.6 (A4), U4.18 (DQ4), U6.6 (A4)
/VB_{1}D_{5}: U2.7 (A5), U4.19 (DQ5), U6.7 (A5)
/VB_{1}D_{6}: U2.8 (A6), U4.20 (DQ6), U6.8 (A6)
/VB_{1}D_{7}: U2.9 (A7), U4.21 (DQ7), U6.9 (A7)
/VB_{1}D_{8}: U7.2 (A0), U9.2 (A0), U12.13 (DQ0)
/VB_{1}D_{9}: U7.3 (A1), U9.3 (A1), U12.14 (DQ1)
/VB_{1}D_{10}: U7.4 (A2), U9.4 (A2), U12.15 (DQ2)
/VB_{1}D_{11}: U7.5 (A3), U9.5 (A3), U12.17 (DQ3)
/VB_{1}D_{12}: U7.6 (A4), U9.6 (A4), U12.18 (DQ4)
/VB_{1}D_{13}: U7.7 (A5), U9.7 (A5), U12.19 (DQ5)
/VB_{1}D_{14}: U7.8 (A6), U9.8 (A6), U12.20 (DQ6)
/VB_{1}D_{15}: U7.9 (A7), U9.9 (A7), U12.21 (DQ7)
/vga_interface/BLUE: J6.3, R31.2
/vga_interface/GREEN: J6.2, R32.2
/vga_interface/RED: J6.1, R33.2
/vga_interface/~HSYNC: J6.13, R26.2
/vga_interface/~VSYNC: J6.14, R25.2
/~BE_{L}: U15.5 (I0b), U16.6 (I1b), U20.16 (I/O)
/~BE_{U}: U15.2 (I0a), U16.3 (I1a), U20.17 (I/O)
/~CME: U17.4 (I/O), U23.18 (~CE)
/~CMO: U17.61 (I/O), U23.20 (~OE)
/~HS: R24.1, U17.27 (I/O)
/~RES: J5.13, U20.1 (I/GCLR)
/~RIH: J2.3, U20.8 (I/O)
/~VBS: U2.1 (G1), U2.19 (G2), U5.19 (CE), U7.1 (G1), U7.19 (G2), U8.19 (CE), U13.1 (G1), U13.19 (G2), U18.1 (G1), U18.19 (G2), U20.9 (I/O), U22.1 (G1), U22.19 (G2), U26.1 (G1), U26.19 (G2), U32.1 (G1), U32.19 (G2)
/~VME: U15.3 (I1a), U15.6 (I1b), U16.2 (I0a), U16.5 (I0b), U17.33 (I/O)
/~VMO: U15.13 (I1d), U16.14 (I0d), U17.31 (I/O)
/~VS: C8.2, R35.1, U17.39 (I/O), U20.43 (I/GCLK1)
GND: B1.2, B2.2, B3.2, B4.2, B5.2, B6.2, B7.2, B8.2, B9.2, B10.2, B11.2, B12.2, B13.2, B14.2, B15.2, B16.2, B17.2, B18.2, B19.2, B20.2, B21.2, B22.2, B23.2, B24.2, B25.2, B26.2, B27.2, B28.2, B29.2, B30.2, B31.2, B32.2, B33.2, B34.1, B35.1, B36.1, B37.1, C1.2, C2.2, C3.2, C4.2, C5.2, C6.2, C7.1, C9.2, J1.2, J1.10, J2.4, J2.10, J2.16, J2.22, J2.28, J2.34, J2.40, J2.46, J2.52, J2.58, J3.2, J4.2, J5.4, J5.10, J5.16, J5.21, J5.22, J5.28, J6.5, J6.6, J6.7, J6.8, J6.10, M1.1, M2.1, M3.1, M4.1, Q1.3 (E), R1.1, R2.1, R6.1, R21.1, R22.1, R23.1, U1.10 (GND), U2.10 (GND), U3.1 (A18), U3.16 (VSS), U4.1 (A18), U4.16 (VSS), U5.10 (GND), U6.10 (GND), U7.10 (GND), U8.10 (GND), U9.10 (GND), U10.10 (GND), U11.1 (A18), U11.16 (VSS), U12.1 (A18), U12.16 (VSS), U13.10 (GND), U14.10 (GND), U15.8 (GND), U15.15 (E), U16.8 (GND), U16.15 (E), U17.7 (GND), U17.19 (GND), U17.32 (GND), U17.42 (GND), U17.47 (GND), U17.59 (GND), U17.72 (GND), U17.82 (GND), U18.10 (GND), U19.10 (GND), U20.10 (GND), U20.22 (GND), U20.30 (GND), U20.42 (GND), U21.10 (GND), U22.10 (GND), U23.12 (GND), U24.2 (A0), U24.3 (A1), U24.4 (A2), U24.6 (A4), U24.8 (A6), U24.9 (A7), U24.10 (GND), U25.10 (GND), U26.10 (GND), U31.10 (GND), U32.10 (GND), Y1.4 (GND)
unnamed: J3.1, R9.1
unnamed: J4.1, Q2.3 (E)
unnamed: Q1.2 (B), R5.2
unnamed: Q1.1 (C), R20.2
unnamed: Q2.2 (B), R20.1
unnamed: R1.2, R3.2, R7.1
unnamed: R2.2, R4.2, R8.1
unnamed: R6.2, R10.2, R13.1
unnamed: R7.2, R11.2, R14.1
unnamed: R8.2, R12.2, R15.1
unnamed: R25.1, R30.2, U30.7
unnamed: R26.1, R34.2, U30.1
unnamed: R27.2, R31.1, U27.6
unnamed: R28.2, R32.1, U28.6
unnamed: R29.2, R33.1, U29.6
unnamed: C8.1, R16.2, U24.1 (G1)
unnamed: R13.2, R17.2, R21.2, U27.3 (+)
unnamed: R27.1, U27.2 (-)
unnamed: R14.2, R18.2, R22.2, U28.3 (+)
unnamed: R28.1, U28.2 (-)
unnamed: R15.2, R19.2, R23.2, U29.3 (+)
unnamed: R29.1, U29.2 (-)
unnamed: R24.2, U30.3 (+)
unnamed: R34.1, U30.2 (-)
unnamed: R35.2, U30.5 (+)
unnamed: R30.1, U30.6 (-)
OE1_+12V: C5.1, R9.2, U17.84 (I/OE1), U20.44 (I/OE1)
VCC_VGA+: B28.1, B29.1, B30.1, B31.1, C4.1, Q2.1 (C), U27.7 (V+), U28.7 (V+), U29.7 (V+), U30.8 (V+)
VCC_VGA-: B34.2, B35.2, B36.2, B37.2, C7.2, J4.3, U27.4 (V-), U28.4 (V-), U29.4 (V-), U30.4 (V-)
