scefrom/SF68/lcd2x16/minimal/lcd2x16.kicad_pcb

## KiCad design lcd2x16/minimal/lcd2x16.kicad_pcb (2026-04-06)

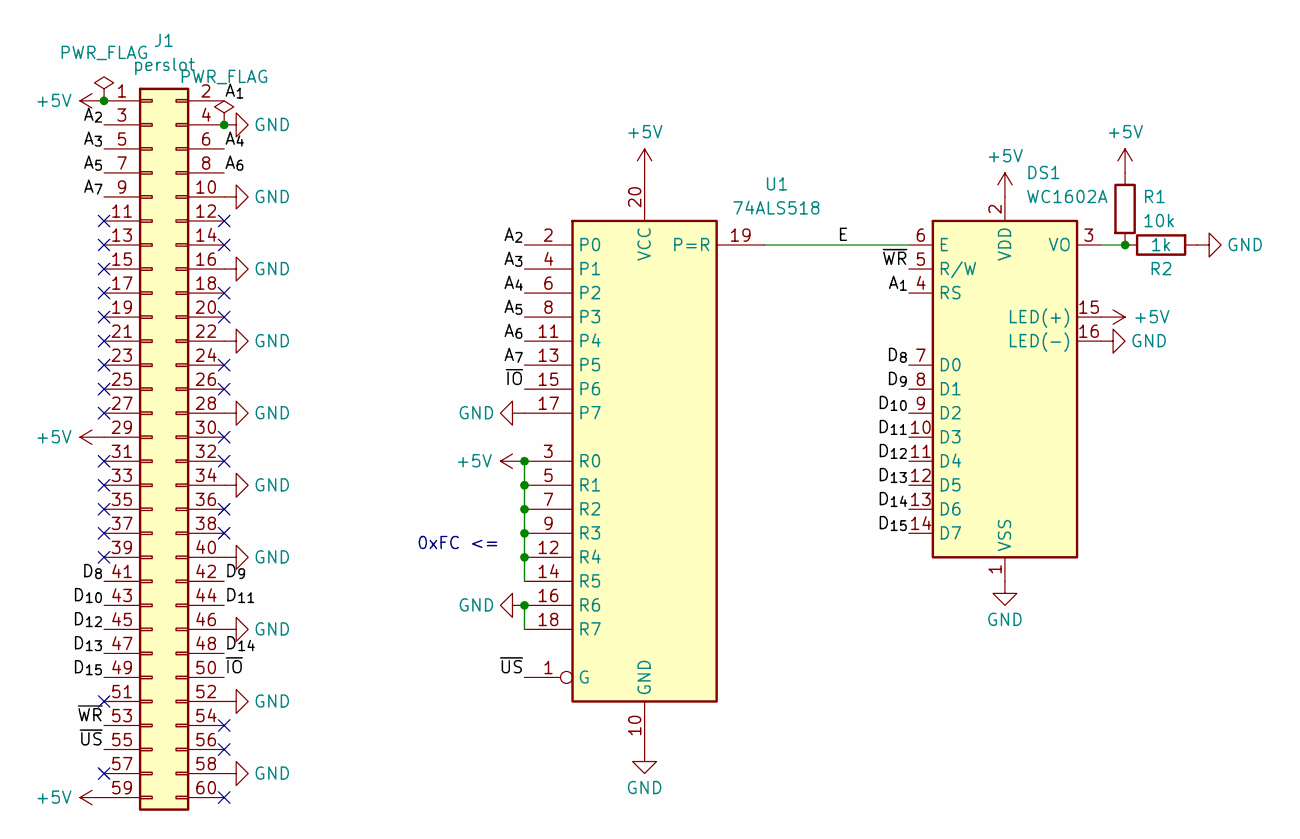
[picture p22: schematic lcd2x16.kicad_sch]

Parts:
DS1: WC1602A
J1: perslot; IDC-Header_2x30_P2.54mm_Horizontal
R1: 10k; R_Axial_DIN0207_L6.3mm_D2.5mm_P7.62mm_Horizontal
R2: 1k; R_Axial_DIN0207_L6.3mm_D2.5mm_P7.62mm_Horizontal
U1: 74ALS518; DIP-20_W7.62mm

Connections:
+5V: DS1.2 (VDD), DS1.15 (LED(+)), J1.1, J1.29, J1.59, R1.1, U1.3 (R0), U1.5 (R1), U1.7 (R2), U1.9 (R3), U1.12 (R4), U1.14 (R5), U1.20 (VCC)
/A_{1}: DS1.4 (RS), J1.2
/A_{2}: J1.3, U1.2 (P0)
/A_{3}: J1.5, U1.4 (P1)
/A_{4}: J1.6, U1.6 (P2)
/A_{5}: J1.7, U1.8 (P3)
/A_{6}: J1.8, U1.11 (P4)
/A_{7}: J1.9, U1.13 (P5)
/D_{8}: DS1.7 (D0), J1.41
/D_{9}: DS1.8 (D1), J1.42
/D_{10}: DS1.9 (D2), J1.43
/D_{11}: DS1.10 (D3), J1.44
/D_{12}: DS1.11 (D4), J1.45
/D_{13}: DS1.12 (D5), J1.47
/D_{14}: DS1.13 (D6), J1.48
/D_{15}: DS1.14 (D7), J1.49
/E: DS1.6 (E), U1.19 (P=R)
/~IO: J1.50, U1.15 (P6)
/~US: J1.55, U1.1 (G)
/~WR: DS1.5 (R/W), J1.53
GND: DS1.1 (VSS), DS1.16 (LED(-)), J1.4, J1.10, J1.16, J1.22, J1.28, J1.34, J1.40, J1.46, J1.52, J1.58, R2.2, U1.10 (GND), U1.16 (R6), U1.17 (P7), U1.18 (R7)
unnamed: DS1.3 (VO), R1.2, R2.1

Notes on the sheet:
0xFC <=

Board: 2 copper layers, 5 parts (0 on the bottom side), 22 nets, no tracks yet.
