scefrom/SF68/ps2/ps2.kicad_pcb

## KiCad design ps2/ps2.kicad_pcb (2026-04-06)

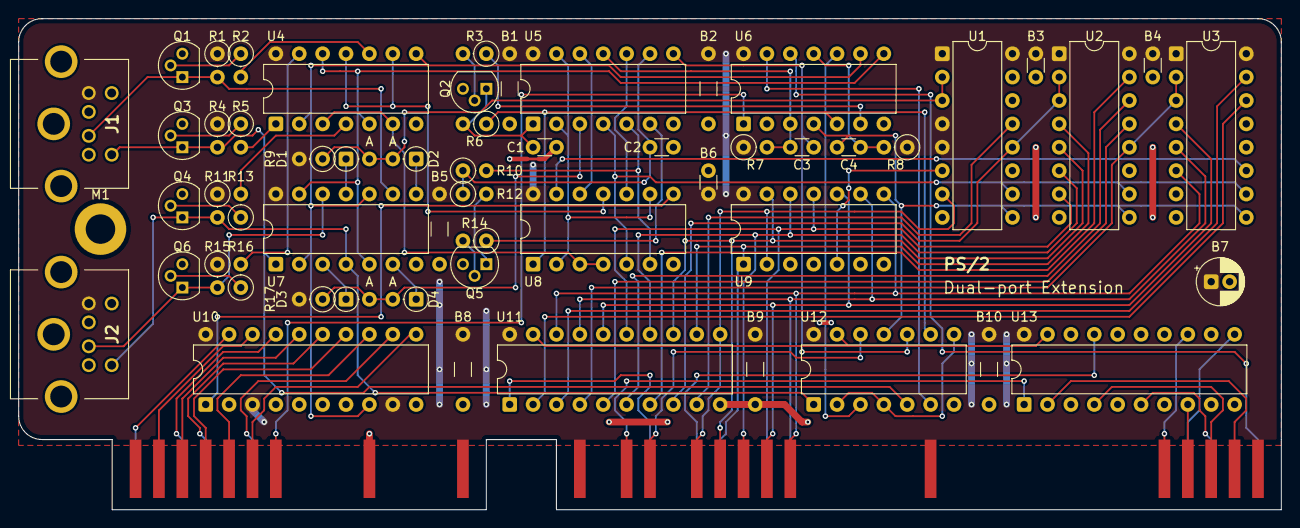
[picture p23: board ps2.kicad_pcb from above]

Board: 2 copper layers, 137.2 x 53.3 mm, 59 parts (0 on the bottom side), 85 nets.

Parts:
B1, B2, B5, B8, B9, B10: 100n; C_Disc_D3.0mm_W1.6mm_P7.62mm
B3, B4, B6: 100n; C_Disc_D3.0mm_W1.6mm_P2.54mm
B7: 10u; CP_Radial_D5.0mm_P2.00mm
C1, C2: 10n; C_Disc_D3.0mm_W1.6mm_P2.54mm
C3: 220p; C_Disc_D3.0mm_W1.6mm_P2.54mm
C4: 22p; C_Disc_D3.0mm_W1.6mm_P2.54mm
D1, D2, D3, D4: schotty; D_DO-35_SOD27_P2.54mm_Vertical_AnodeUp
J1: port0; 57492651
J2: port1; 57492651
J3: perslot1b; edge_connector_15p_2.54mm
J4: perslot1a; edge_connector_30p_2.54mm
M1: MountingHole_3.2mm_M3_DIN965_Pad
Q1, Q2, Q3, Q4, Q5, Q6: BC547B; TO-92
R1, R4, R11, R15: 4k7; R_Axial_DIN0207_L6.3mm_D2.5mm_P2.54mm_Vertical
R2, R3, R5, R9, R10, R13, R14, R16, R17: 10k; R_Axial_DIN0207_L6.3mm_D2.5mm_P2.54mm_Vertical
R6: 14k7; R_Axial_DIN0207_L6.3mm_D2.5mm_P2.54mm_Vertical
R7, R12: 1k; R_Axial_DIN0207_L6.3mm_D2.5mm_P2.54mm_Vertical
R8: 2k; R_Axial_DIN0207_L6.3mm_D2.5mm_P2.54mm_Vertical
U1, U2, U3: 74HC195; DIP-16_W7.62mm
U4: 74HC02; DIP-14_W7.62mm
U5: 74HC14; DIP-14_W7.62mm
U6: 74HC74; DIP-14_W7.62mm
U7, U12: 74HC32; DIP-14_W7.62mm
U8: 74HC00; DIP-14_W7.62mm
U9: 74HC280; DIP-14_W7.62mm
U10, U11: 74HC541; DIP-20_W7.62mm
U13: 74HC688; DIP-20_W7.62mm

Connections:
+5V: B1.1, B2.1, B3.1, B4.1, B5.1, B6.1, B7.1, B8.1, B9.1, B10.1, J1.4, J2.4, J3.1, J3.29, J4.1, J4.31, J4.59, R1.1, R4.1, R7.1, R8.1, R9.2, R11.1, R15.1, R17.2, U1.1 (~MR), U1.4 (P0), U1.5 (P1), U1.16 (VCC), U2.1 (~MR), U2.16 (VCC), U3.1 (~MR), U3.16 (VCC), U4.14 (VCC), U5.14 (VCC), U6.14 (VCC), U7.14 (VCC), U8.14 (VCC), U9.14 (VCC), U10.3 (A1), U10.9 (A7), U10.20 (VCC), U11.20 (VCC), U12.14 (VCC), U13.20 (VCC)
/A_{1}: J4.60, U6.12 (D)
/A_{2}: J4.57, U13.2 (P0)
/A_{3}: J4.55, U13.4 (P1)
/A_{4}: J4.56, U13.6 (P2)
/A_{5}: J4.53, U13.8 (P3)
/A_{6}: J4.54, U13.11 (P4)
/A_{7}: J4.51, U13.13 (P5)
/BE.~IO: J4.12, U13.17 (P7)
/CP: U1.10 (CP), U2.10 (CP), U3.10 (CP), U5.4, U8.5
/DAT_{0}: J1.1, Q1.1 (C), R1.2, U7.9
/DAT_{1}: J2.1, Q6.1 (C), R15.2, U7.12
/DAT_{d}: D1.2 (A), D2.2 (A), R9.1, U1.2 (J), U1.3 (~K)
/DAT_{h}: U4.9, U4.11, U8.11
/DIR.~R: J4.8, U11.1 (G1)
/DIR.~W: J4.7, U12.12
/DS.~U: J4.5, U13.1 (G)
/D_{8}: J4.19, U3.6 (P2), U9.8 (A), U11.18 (Y0)
/D_{9}: J4.20, U3.5 (P1), U9.9 (B), U11.17 (Y1)
/D_{10}: J4.17, U3.4 (P0), U9.10 (C), U11.16 (Y2)
/D_{11}: J4.18, U2.7 (P3), U9.11 (D), U11.15 (Y3)
/D_{12}: J4.15, U2.6 (P2), U9.12 (E), U11.14 (Y4)
/D_{13}: J4.13, U2.5 (P1), U9.13 (F), U11.13 (Y5)
/D_{14}: J4.14, U2.4 (P0), U9.1 (G), U11.12 (Y6)
/D_{15}: J4.11, U1.7 (P3), U9.2 (H), U11.11 (Y7)
/IBSY: J3.2, U10.19 (G2)
/IRQ_{0}: J3.11, U10.11 (Y7)
/IRQ_{1}: J3.12, U10.12 (Y6)
/IRQ_{2}: J3.9, U10.13 (Y5)
/IRQ_{3}: J3.7, U10.14 (Y4)
/IRQ_{4}: J3.8, U10.15 (Y3)
/IRQ_{5}: J3.5, U10.16 (Y2)
/IRQ_{6}: J3.6, U10.17 (Y1)
/IRQ_{7}: J3.3, U10.18 (Y0)
/PORT: U4.2, U4.8, U6.9 (Q), U7.2, U7.10, U10.8 (A6)
/SBSY: R6.1, U6.5 (Q), U8.1, U12.9
/TBSY: C3.2, U5.8, U12.10
/ports_mux/~P_{1}: U4.5, U4.12, U6.8 (~Q), U7.5, U7.13
/shift_registers/D_{q0}: U3.14 (Q1), U11.2 (A0)
/shift_registers/D_{q1}: U3.15 (Q0), U11.3 (A1)
/shift_registers/D_{q2}: U2.12 (Q3), U3.2 (J), U3.3 (~K), U11.4 (A2)
/shift_registers/D_{q3}: U2.13 (Q2), U11.5 (A3)
/shift_registers/D_{q4}: U2.14 (Q1), U11.6 (A4)
/shift_registers/D_{q5}: U2.15 (Q0), U11.7 (A5)
/shift_registers/D_{q6}: U1.12 (Q3), U2.2 (J), U2.3 (~K), U11.8 (A6)
/shift_registers/D_{q7}: U1.13 (Q2), U11.9 (A7)
/shift_registers/EPAR: U1.6 (P2), U9.5 (Even)
/~CLK_{0}: J1.5, Q3.1 (C), R4.2, U7.1, U12.5
/~CLK_{1}: J2.5, Q4.1 (C), R11.2, U7.4, U12.1
/~CLK_{d}: D3.2 (A), D4.2 (A), R17.1, U5.3
/~CLK_{h}: U4.3, U4.6, U8.3, U8.4
/~D_{q}: U3.11 (~Q3), U8.13
/~RCV: U8.8, U10.1 (G1)
/~RES: J3.13, U6.1 (~R)
/~S: U11.19 (G2), U12.13, U13.19 (P=R)
/~W: C4.1, U1.9 (~PE), U2.9 (~PE), U3.9 (~PE), U6.4 (~S), U12.11
GND: B1.2, B2.2, B3.2, B4.2, B5.2, B6.2, B7.2, B8.2, B9.2, B10.2, C1.2, C2.2, J1.3, J1.7, J1.8, J1.9, J2.3, J2.7, J2.8, J2.9, J3.4, J3.10, J3.16, J3.21, J3.22, J3.28, J4.4, J4.10, J4.16, J4.22, J4.28, J4.34, J4.40, J4.46, J4.52, J4.58, M1.1, Q1.3 (E), Q2.3 (E), Q3.3 (E), Q4.3 (E), Q5.3 (E), Q6.3 (E), U1.8 (GND), U2.8 (GND), U3.7 (P3), U3.8 (GND), U4.7 (GND), U5.7 (GND), U6.2 (D), U6.7 (GND), U7.7 (GND), U8.7 (GND), U9.4 (I), U9.7 (GND), U10.2 (A0), U10.4 (A2), U10.5 (A3), U10.6 (A4), U10.7 (A5), U10.10 (GND), U11.10 (GND), U12.7 (GND), U13.3 (R0), U13.5 (R1), U13.7 (R2), U13.9 (R3), U13.10 (GND), U13.12 (R4), U13.14 (R5), U13.15 (P6), U13.16 (R6), U13.18 (R7)
unnamed: C2.1, R10.1, R12.1, U5.9
unnamed: D1.1 (K), U7.11
unnamed: D2.1 (K), U7.8
unnamed: D3.1 (K), U7.3
unnamed: D4.1 (K), U7.6
unnamed: Q1.2 (B), R2.1
unnamed: Q2.2 (B), R3.2
unnamed: C1.1, Q2.1 (C), R6.2, U5.1
unnamed: Q3.2 (B), R5.1
unnamed: Q4.2 (B), R13.1
unnamed: Q5.2 (B), R14.2
unnamed: Q5.1 (C), R12.2
unnamed: Q6.2 (B), R16.1
unnamed: R2.2, U4.10
unnamed: R5.2, U4.1
unnamed: R10.2, U5.5, U8.6
unnamed: R13.2, U4.4
unnamed: R14.1, U5.6
unnamed: R16.2, U4.13
unnamed: U5.10, U8.10
unnamed: U5.12, U8.12
unnamed: U5.2, U5.13, U8.2, U8.9
unnamed: C3.1, R7.2, U5.11, U6.3 (C)
unnamed: R3.1, U6.6 (~Q)
unnamed: C4.2, R8.2, U6.11 (C)
unnamed: U6.13 (~R), U12.6
unnamed: U6.10 (~S), U12.3
unnamed: U12.2, U12.4, U12.8
