scefrom/SF68/lcd2x16/lcd2x16.kicad_pcb

## KiCad design lcd2x16/lcd2x16.kicad_pcb (2026-01-17, an earlier design)

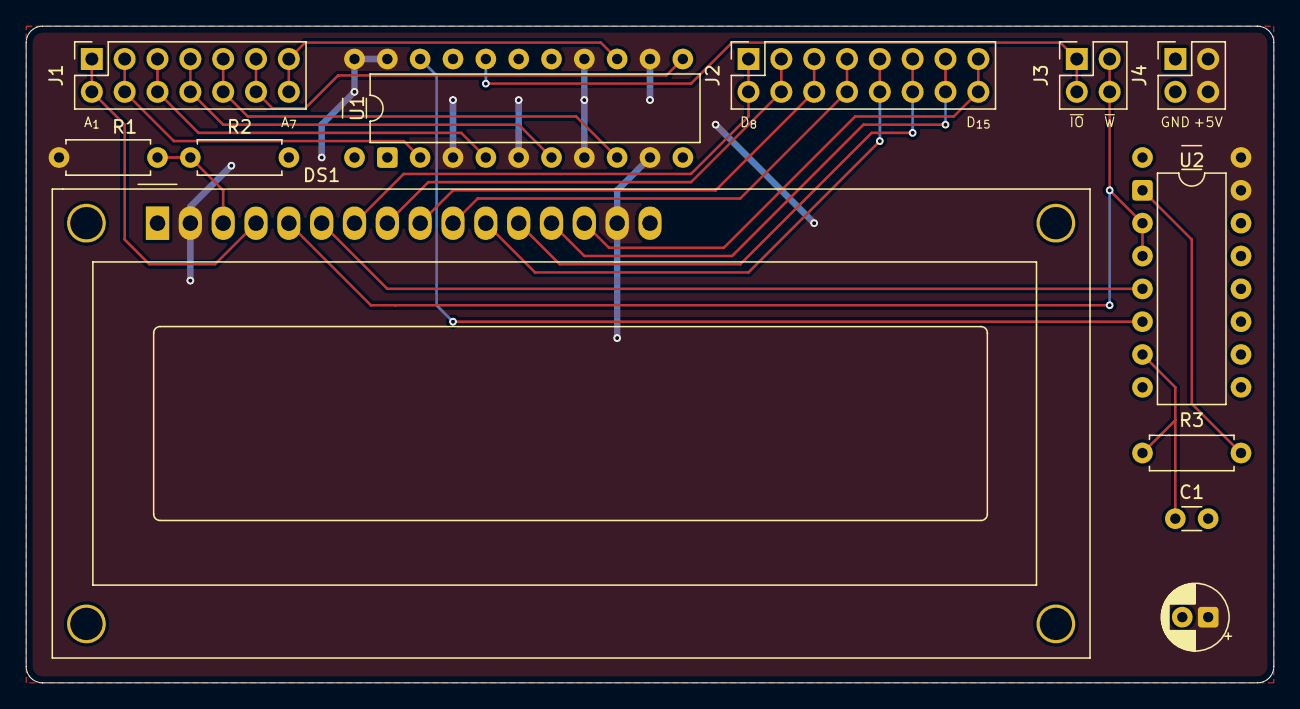
[picture p24: board lcd2x16/lcd2x16.kicad_pcb from above]

Board: 2 copper layers, 96.5 x 50.8 mm, 14 parts (0 on the bottom side), 24 nets.

Parts:
C1: 220pF; C_Disc_D3.0mm_W1.6mm_P2.54mm
CB1, CB2: C_Disc_D3.0mm_W1.6mm_P7.62mm
CB3: CP_Radial_D5.0mm_P2.00mm
DS1: WC1602A
J1: Aport; PinSocket_2x07_P2.54mm_Vertical
J2: Dport; PinSocket_2x08_P2.54mm_Vertical
J3: Cport; PinSocket_2x02_P2.54mm_Vertical
J4: Pport; PinSocket_2x02_P2.54mm_Vertical
R1: 10k; R_Axial_DIN0207_L6.3mm_D2.5mm_P7.62mm_Horizontal
R2, R3: 1k; R_Axial_DIN0207_L6.3mm_D2.5mm_P7.62mm_Horizontal
U1: 74HC688; DIP-20_W7.62mm
U2: 74HC02; DIP-14_W7.62mm

Connections:
+5V: CB1.1, CB2.1, CB3.1, DS1.2 (VDD), DS1.15 (LED(+)), J4.3, J4.4, R1.1, U1.3 (R0), U1.5 (R1), U1.7 (R2), U1.9 (R3), U1.12 (R4), U1.14 (R5), U1.20 (VCC), U2.14 (VCC)
/E: DS1.6 (E), U2.4
/~S: U1.19 (P=R), U2.5
A_{1}: DS1.4 (RS), J1.1, J1.2
A_{2}: J1.3, J1.4, U1.2 (P0)
A_{3}: J1.5, J1.6, U1.4 (P1)
A_{4}: J1.7, J1.8, U1.6 (P2)
A_{5}: J1.9, J1.10, U1.8 (P3)
A_{6}: J1.11, J1.12, U1.11 (P4)
A_{7}: J1.13, J1.14, U1.13 (P5)
BE.~IO: J3.1, J3.2, U1.17 (P7)
DIR.~W: DS1.5 (R/W), J3.3, J3.4, U2.2, U2.3
D_{8}: DS1.7 (D0), J2.1, J2.2
D_{9}: DS1.8 (D1), J2.3, J2.4
D_{10}: DS1.9 (D2), J2.5, J2.6
D_{11}: DS1.10 (D3), J2.7, J2.8
D_{12}: DS1.11 (D4), J2.9, J2.10
D_{13}: DS1.12 (D5), J2.11, J2.12
D_{14}: DS1.13 (D6), J2.13, J2.14
D_{15}: DS1.14 (D7), J2.15, J2.16
GND: C1.2, CB1.2, CB2.2, CB3.2, DS1.1 (VSS), DS1.16 (LED(-)), J4.1, J4.2, R2.2, U1.1 (G), U1.10 (GND), U1.15 (P6), U1.16 (R6), U1.18 (R7), U2.7 (GND), U2.8, U2.9, U2.11, U2.12
unnamed: C1.1, R3.2, U2.6
unnamed: DS1.3 (VO), R1.2, R2.1
unnamed: R3.1, U2.1
