scefrom/SF68/ram1M/ram1M.kicad_pcb

## KiCad design ram1M/ram1M.kicad_pcb (2025-10-06)

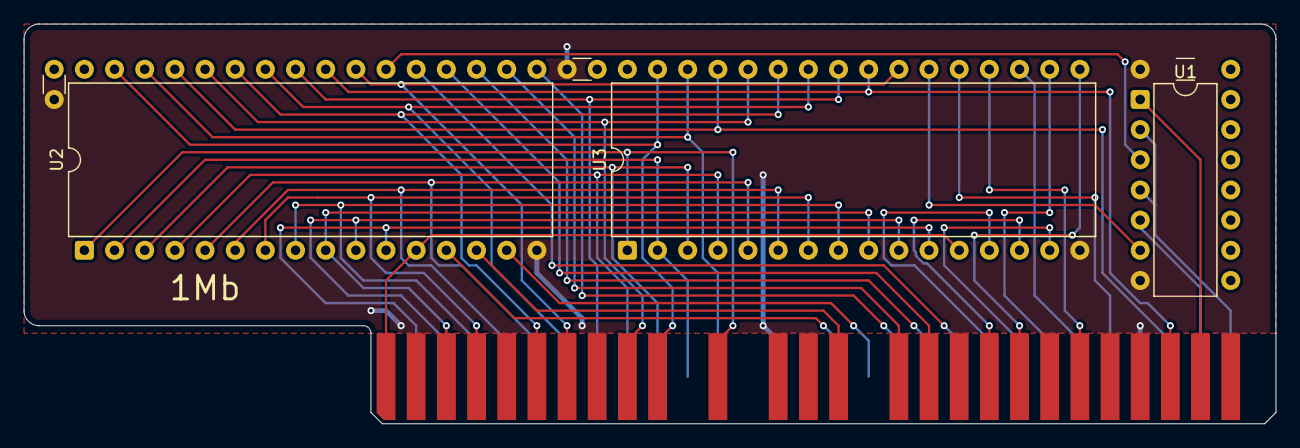
[picture p25: board ram1M.kicad_pcb from above]

Board: 2 copper layers, 105.4 x 33.7 mm, 7 parts (0 on the bottom side), 44 nets.

Parts:
CB1, CB1#3: C_Disc_D3.0mm_W1.6mm_P2.54mm
CB1#2: C_Disc_D3.0mm_W1.6mm_P7.62mm
J5: ramslot; pcb_edge_60_P2.54_new
U1: 74HC32; DIP-14_W7.62mm
U2, U3: AS6C4008-55PCN; DIP-32_W15.24mm

Connections:
+5V: CB1.1, CB1#2.1, CB1#3.1, J5.2, J5.30, J5.60, U1.9, U1.10, U1.12, U1.13, U1.14 (VCC), U2.32 (VCC), U3.32 (VCC)
/A_{1}: J5.1, U2.12 (A0), U3.12 (A0)
/A_{2}: J5.4, U2.11 (A1), U3.11 (A1)
/A_{3}: J5.6, U2.10 (A2), U3.10 (A2)
/A_{4}: J5.5, U2.9 (A3), U3.9 (A3)
/A_{5}: J5.8, U2.8 (A4), U3.8 (A4)
/A_{6}: J5.7, U2.7 (A5), U3.7 (A5)
/A_{7}: J5.10, U2.6 (A6), U3.6 (A6)
/A_{8}: J5.12, U2.5 (A7), U3.5 (A7)
/A_{9}: J5.11, U2.27 (A8), U3.27 (A8)
/A_{10}: J5.14, U2.26 (A9), U3.26 (A9)
/A_{11}: J5.13, U2.23 (A10), U3.23 (A10)
/A_{12}: J5.16, U2.25 (A11), U3.25 (A11)
/A_{13}: J5.18, U2.4 (A12), U3.4 (A12)
/A_{14}: J5.17, U2.28 (A13), U3.28 (A13)
/A_{15}: J5.20, U2.3 (A14), U3.3 (A14)
/A_{16}: J5.19, U2.31 (A15), U3.31 (A15)
/A_{17}: J5.22, U2.2 (A16), U3.2 (A16)
/A_{18}: J5.24, U2.30 (A17), U3.30 (A17)
/A_{19}: J5.23, U2.1 (A18), U3.1 (A18)
/DIR.~R: J5.53, U2.24 (OE#), U3.24 (OE#)
/DIR.~W: J5.54, U2.29 (WE#), U3.29 (WE#)
/DS.~L: J5.55, U1.1
/DS.~U: J5.56, U1.5
/D_{0}: J5.32, U2.13 (DQ0)
/D_{1}: J5.31, U2.14 (DQ1)
/D_{2}: J5.34, U2.15 (DQ2)
/D_{3}: J5.36, U2.17 (DQ3)
/D_{4}: J5.35, U2.18 (DQ4)
/D_{5}: J5.38, U2.19 (DQ5)
/D_{6}: J5.37, U2.20 (DQ6)
/D_{7}: J5.40, U2.21 (DQ7)
/D_{8}: J5.42, U3.13 (DQ0)
/D_{9}: J5.41, U3.14 (DQ1)
/D_{10}: J5.44, U3.15 (DQ2)
/D_{11}: J5.43, U3.17 (DQ3)
/D_{12}: J5.46, U3.18 (DQ4)
/D_{13}: J5.48, U3.19 (DQ5)
/D_{14}: J5.47, U3.20 (DQ6)
/D_{15}: J5.50, U3.21 (DQ7)
/~BKE: J5.58, U1.2, U1.4
/~LS: U1.3, U2.22 (CE#)
/~US: U1.6, U3.22 (CE#)
GND: CB1.2, CB1#2.2, CB1#3.2, J5.3, J5.9, J5.15, J5.27, J5.28, J5.29, J5.39, J5.45, J5.49, J5.51, J5.52, J5.57, U1.7 (GND), U2.16 (VSS), U3.16 (VSS)
