scefrom/SF68/(commit log)

2025-07-14 finished scheme, footprints not completely assigned yet
    [SCRM6816.kicad_pcb, SCRM6816.kicad_sch, atu.kicad_sch, atu_buffers.kicad_sch, atu_pidreg.kicad_sch, decoder.kicad_sch, ilatch.kicad_sch, peripherals.kicad_sch]
2025-07-15 done the pcb layout + added the 1M ram bank project
    [SCRM6816.kicad_pcb, SCRM6816.kicad_sch, atu.kicad_sch, atu_buffers.kicad_sch, atu_pidreg.kicad_sch, decoder.kicad_sch, ilatch.kicad_sch, peripherals.kicad_sch]
2025-07-20 updated scheme: - fixed E to P & PRT mapping - swapped root's 04 couple with the 14's of pidreg & statusreg
    [SCRM6816.kicad_sch, atu_pidreg.kicad_sch, peripherals.kicad_sch, ram.kicad_sch, statusreg.kicad_sch]
2025-07-20 routing: progress 1
    [SCRM6816.kicad_pcb]
2025-07-26 apparently the ram was enabled all the time, ram.kicad_sch didn't even require BE.M... like whaaaaaaaa how did i let this happen oh my god sometimes im just braindead.
    [SCRM6816.kicad_sch, ram.kicad_sch, statusreg.kicad_sch]
2025-07-26 connected ram slots to A & D bus
    [SCRM6816.kicad_pcb]
2025-08-03 [scheme] no major changes
    [SCRM6816.kicad_sch, rom.kicad_sch]
2025-08-03 connected A16-23 to atu
    [SCRM6816.kicad_pcb]
2025-08-03 added black pcb png
2025-08-06 first commit: scheme ok [decoder]: - new spv. address space [mmu]: - removed pidreg - switched back to 8Kb mmu rams [ram/peripherals]: - added ground pins to connectors [misc]: - added DMA support - 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
    [SCRM6816.kicad_sch, atu.kicad_sch, atu_buffers.kicad_sch, atu_pidreg.kicad_sch, decoder.kicad_sch, ilatch.kicad_sch, peripherals.kicad_sch, power&reset.kicad_sch]
2025-08-06 assigned footprints
    [SCRM6816.kicad_sch, atu_buffers.kicad_sch, decoder.kicad_sch, peripherals.kicad_sch, ram.kicad_sch, rom.kicad_sch, statusreg.kicad_sch]
2025-10-04 removed SCRM16/10 files
    [SCRM6816.kicad_pcb, SCRM6816.kicad_sch, atu.kicad_sch, atu_buffers.kicad_sch, atu_pidreg.kicad_sch, power&reset.kicad_sch, statusreg.kicad_sch, systimer.kicad_sch]
2025-10-04 SF68's first commit
    [SF68.kicad_sch, dma.kicad_sch, mmu.kicad_sch, mmu_buffers.kicad_sch, ps2.kicad_pcb, ps2.kicad_sch, vga.kicad_pcb, vga.kicad_sch]
2025-10-04 applied sf68 & ps2 fixes stash from master
    [SF68.kicad_sch, decoder.kicad_sch, ilatch.kicad_sch, lcd2x16.kicad_pcb, lcd2x16.kicad_sch, mmu_buffers.kicad_sch, ps2.kicad_pcb, ps2.kicad_sch]
2025-10-05 [ram1M] removed its png, [SF68] removed logic.circ
    [logic.circ]
2025-10-06 [ps2] fixed send request RC constant t must be >= 100us RC was being t, therefore t was actually smaller than 100us RC is now >= 1.28 * 100us (R : 10kohm -> 14.7kohm) t ~= 120us >= 100us
    [ps2.kicad_pcb, ps2.kicad_sch]
2025-10-06 [ram1M] restored from a SF68 backup
    [ram1M.kicad_pcb, ram1M.kicad_sch]
2026-01-17 lcd2x16 ready
    [lcd2x16.kicad_pcb, lcd2x16.kicad_sch, ps2.kicad_sch, vga.kicad_sch]
2026-01-17 ps2 scheme ready
    [controller.kicad_sch, ports_mux.kicad_sch, ps2_new.kicad_pcb, shift_registers.kicad_sch]
2026-01-31 [vga]: completed the extension using CPLDs
    [adrcross.kicad_sch, banks.kicad_sch, banks_addr_muxes.kicad_sch, banks_data_demuxes.kicad_sch, bus_connector.kicad_sch, bus_mapper.kicad_sch, color_muxes.kicad_sch, control_reg.kicad_sch]
2026-02-01 [vga]: added +12V & GND labels on 12V supply connector
    [vga_cpld.kicad_pcb]
2026-02-01 [ps2]: made pcb design of the new latest schematic
    [controller.kicad_sch, ports_mux.kicad_sch, ps2.kicad_pcb, ps2.kicad_sch, ps2_new.kicad_pcb, ps2_old.kicad_pcb, shift_registers.kicad_sch]
2026-02-23 [vga]: made a scheme & pcb version with jtag connector included
    [vga_cpld_jtag.kicad_pcb, vga_cpld_jtag.kicad_sch]
2026-02-23 [ata]: started
    [ata.kicad_pcb, ata.kicad_sch]
2026-03-09 [ps2] changed fingers footprints
    [ps2.kicad_pcb, ps2.kicad_sch]
2026-03-09 [vga] added logos + fixed jtag version
    [bus_connector.kicad_sch, vga_interface.kicad_sch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]
2026-04-06 [ps2] can't remember what i've done
    [ps2.kicad_pcb]
2026-04-06 [ata] started, but i think its destined to not go on.
    [ata.kicad_sch]
2026-04-06 [lcd2x16] found out the additional logic was useless actually
    [lcd2x16.kicad_pcb, lcd2x16.kicad_sch]
2026-04-06 [floppy] started
    [floppy.kicad_pcb, floppy.kicad_sch]
2026-04-06 [vga/jtag] started, fork of original but with jtag port included
    [adrcross.kicad_sch, bus_connector.kicad_sch, datacross.kicad_sch, vga_interface.kicad_sch, vram.kicad_sch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]
2026-04-06 [vga/jtag_fctlines] started, fork of vga/jtag but with 74fct244 as vga line drivers
    [adrcross.kicad_sch, bus_connector.kicad_sch, datacross.kicad_sch, vga_interface.kicad_sch, vram.kicad_sch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]
2026-04-06 [vga/fctlines] started, fork of original but with 74fct244 as vga line drivers
    [adrcross.kicad_sch, bus_connector.kicad_sch, datacross.kicad_sch, vga_interface.kicad_sch, vram.kicad_sch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]
2026-04-06 [vga] added IBM_BIOS bitmap font's 2kb eeprom image + removed some old vga/jtag files
    [vga_cpld_jtag.kicad_pcb, vga_cpld_jtag.kicad_sch]
2026-04-06 [vga/fctlines] corrected errors on schematic. Schematic & PCB are NO longer matching.
    [datacross.kicad_sch, vga_interface.kicad_sch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]
2026-09-20 [floppy] added the 3.5" HD (custom) floppy controller peripheral
    [fdd_interface.kicad_sch, floppy.csv, floppy.kicad_pcb, floppy.kicad_sch]
2026-09-20 [uart] added uart (rs232) (custom) peripheral fixed to 115200 baud, 1 start bit, 8 bits, 1 stop bit, no parity, half duplex, no flow control.
    [uart.kicad_pcb, uart.kicad_sch]
2026-09-20 [spi] added spi peripheral
    [spi.kicad_pcb, spi.kicad_sch]
2026-09-20 [vga/fctlines] commit after a LONG time, i don't remember what i changed
    [bus_connector.kicad_sch, datacross.kicad_sch, vga_interface.kicad_sch, vram.kicad_sch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]
