scefrom/SF68/(notices)

Notices in the files:
ps2/ps2.kicad_pcb:
Copyright © 2026
